robbiesm/MotoZ_Dev/Research/STEP/perforated-pcb-assembly.stp

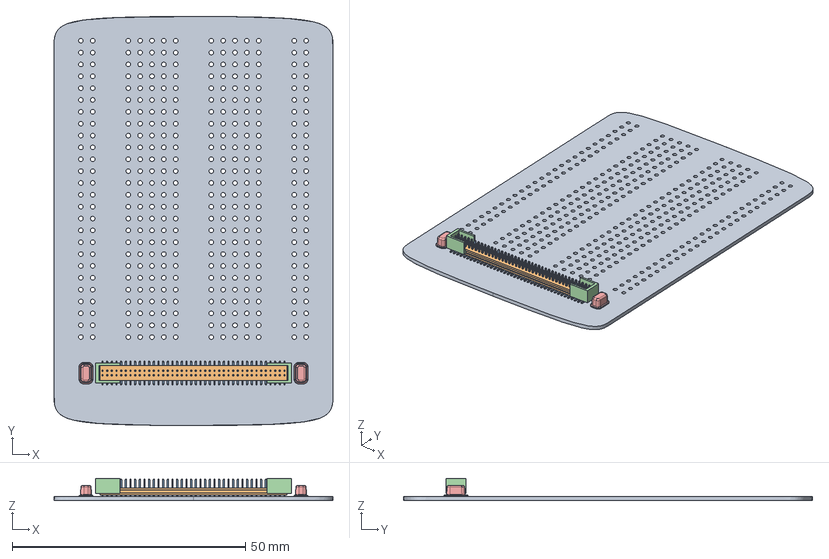
[picture p1: CAD file, 2018-05-24]
Research/STEP/perforated-pcb-assembly.stp
59.7 x 87.6 x 4.78 mm
0_HDK_AMP_SKEL
84016635_HDK_BREADBOARD
_FTMH-140-02-L-DV-ES-P-TR_BODY
_FTMH-140-02-L-DV-ES-P-TR_PINS1
_FTMH-40-ES_SHROUD x 2
PUCK_DETENT_SMT_HDK x 2
