robbiesm/MotoZ_Dev/Research/STEP/personality-card-housing.stp

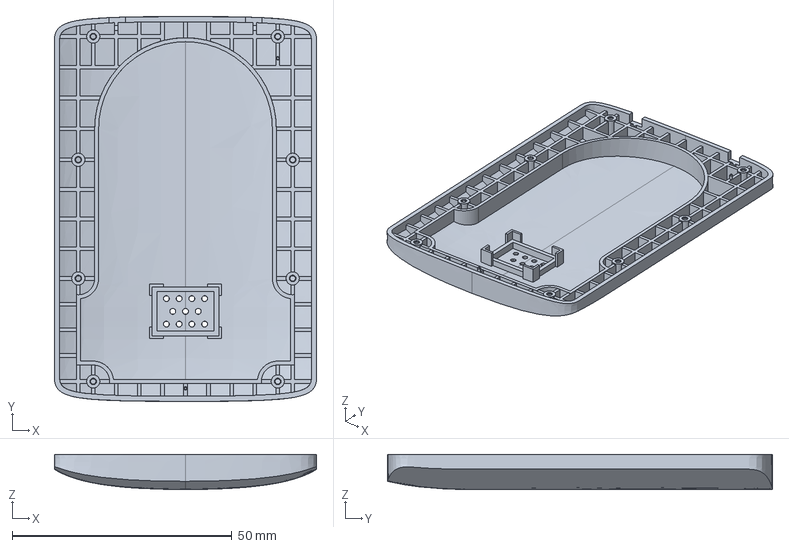
[picture p2: CAD file, 2018-05-24]
Research/STEP/personality-card-housing.stp
59.7 x 87.6 x 7.97 mm
