robbiesm/MotoZ_Dev/Research/STEP/mdk_back_cover.stp

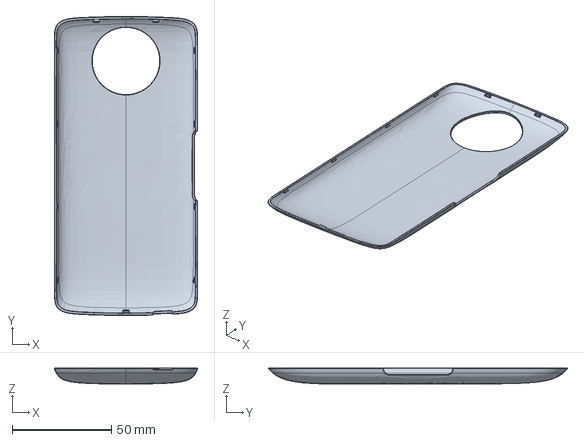
[picture p3: CAD file, 2018-05-24]
Research/STEP/mdk_back_cover.stp
72.2 x 150.4 x 8.04 mm
