robbiesm/MotoZ_Dev/Research/Schematic/DAUGHTER_AUDIO_SCH_0725.pdf

1 | 1
3 | 3

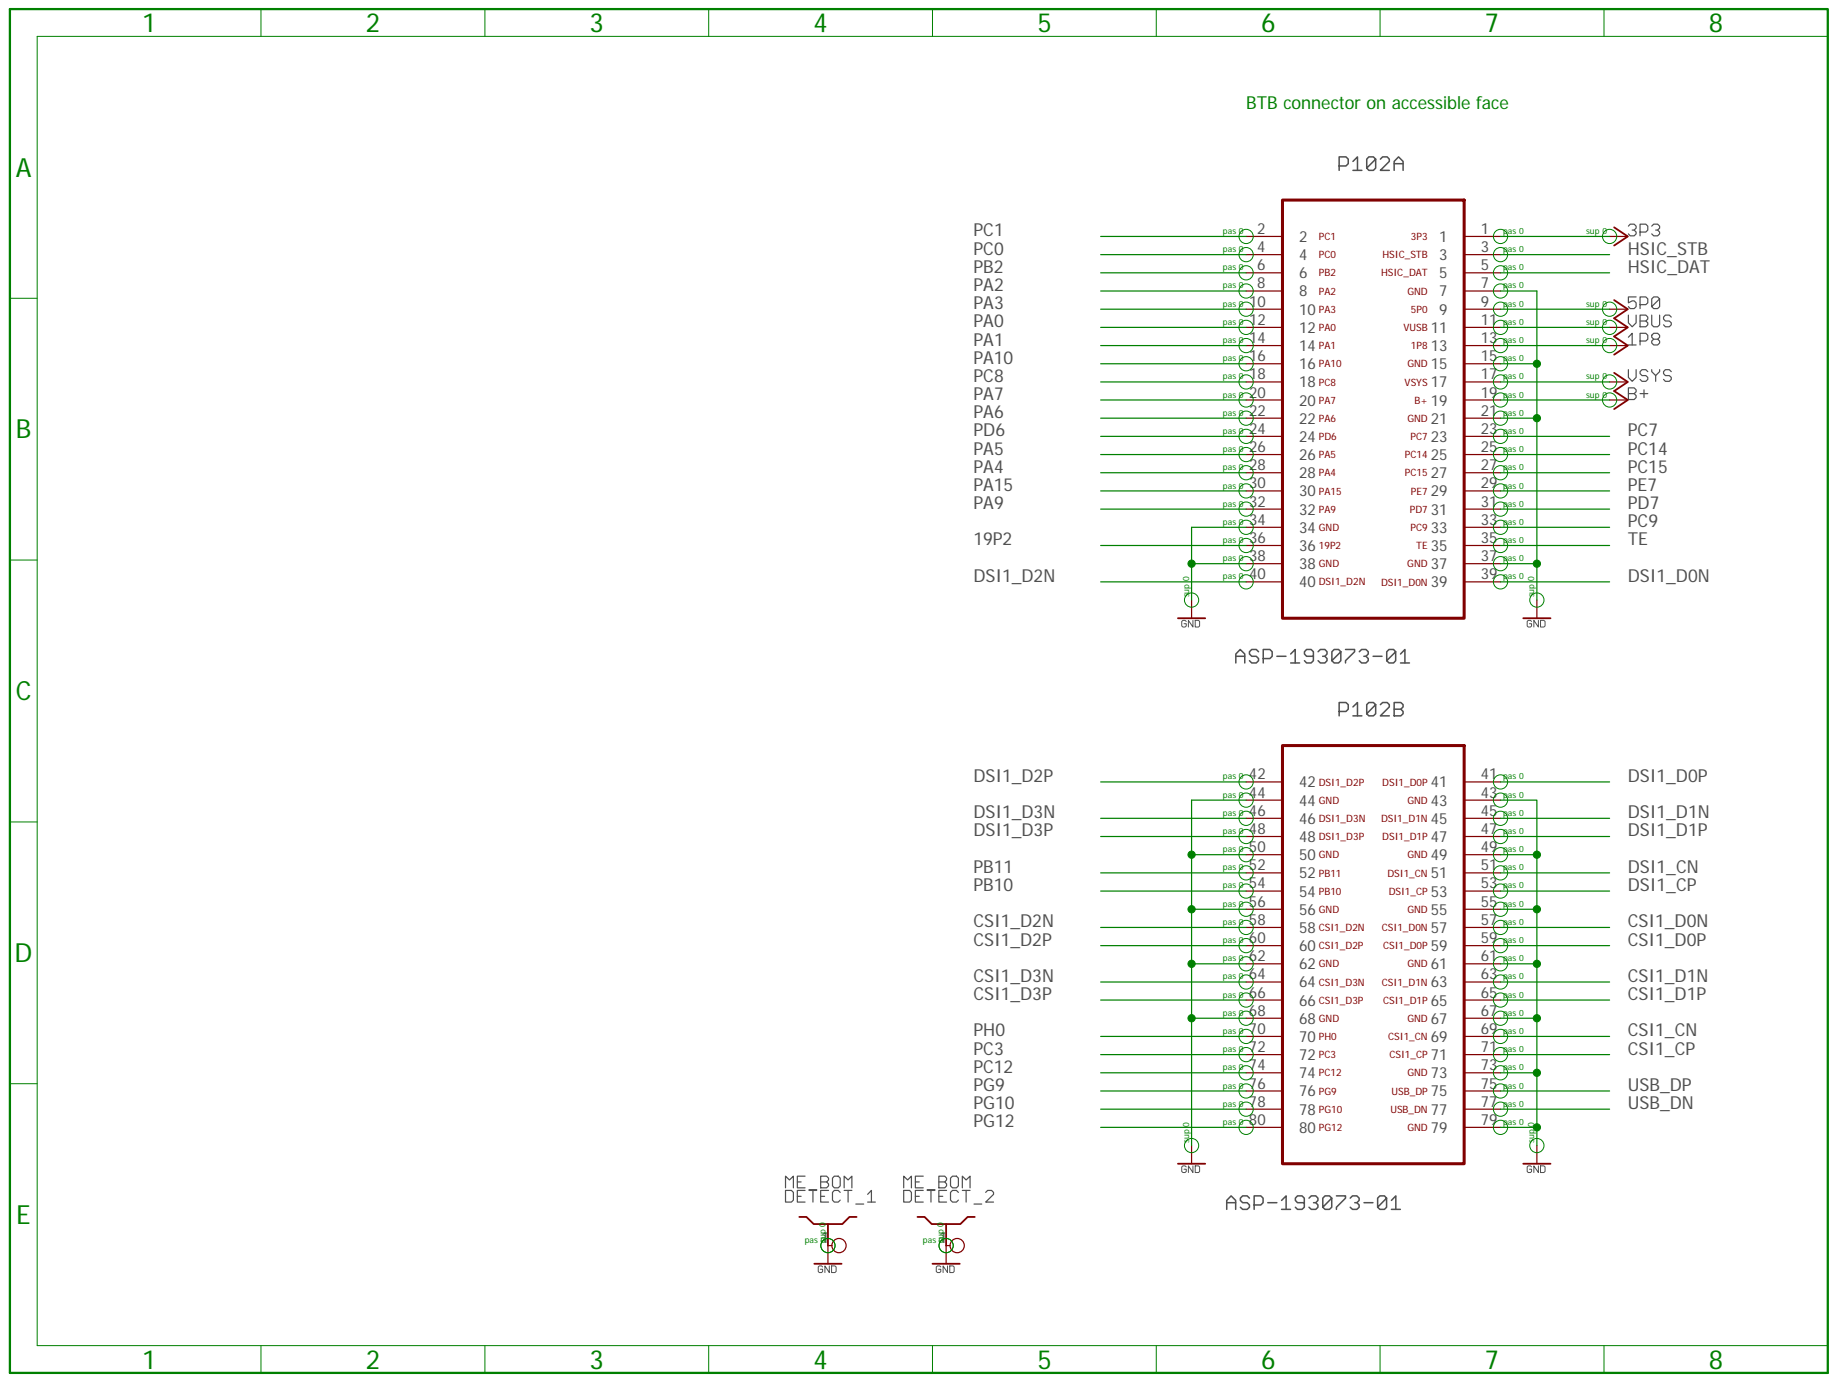
[picture p4: page 1]
HSIC_STB HSIC_DAT; USB_DP USB_DN; DSI1_D2N; DSI1_D0N; DSI1_D2P; DSI1_D3N DSI1_D3P; CSI1_D2N CSI1_D2P; CSI1_D3N CSI1_D3P; CSI1_CP; CSI1_CN; CSI1_D1P; CSI1_D1N; CSI1_D0P; CSI1_D0N; DSI1_CP; DSI1_CN; DSI1_D1P; DSI1_D1N; DSI1_D0P; HSIC_STB; HSIC_DAT GND 5P0 VUSB 1P8 GND VSYS B+ GND PC7 PC14 PC15 PE7 PD7 PC9 TE; GND; DSI1_D0P GND DSI1_D1N DSI1_D1P; DSI1_CN DSI1_CP; CSI1_D0N CSI1_D0P; CSI1_D1N CSI1_D1P; CSI1_CN CSI1_CP; CSI1_D3P; CSI1_D3N; CSI1_D2P; CSI1_D2N; sup 0; pas 0; pas 0sup 0

BTB connector on accessible face

# LED_A

A

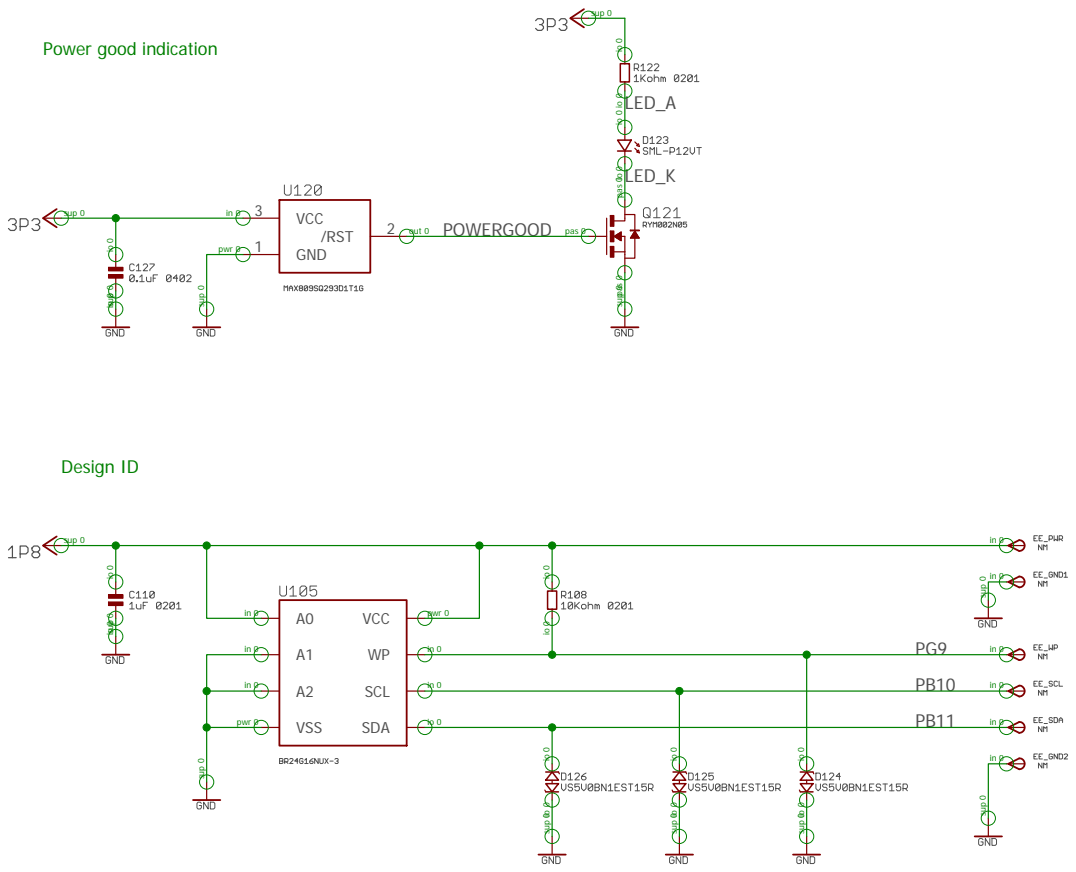
[picture p5: page 2]
VCC 3; GND 1; /RST; VCC; VSS; SDA; SCL; POWERGOOD; LED_K; pwr 0; out 0; sup 0; Design ID

Power good indication

io 0 io 0 pas 0 pas 0 pas 0

io 0 io 0 io 0 io 0 sup 0

U300

PG10

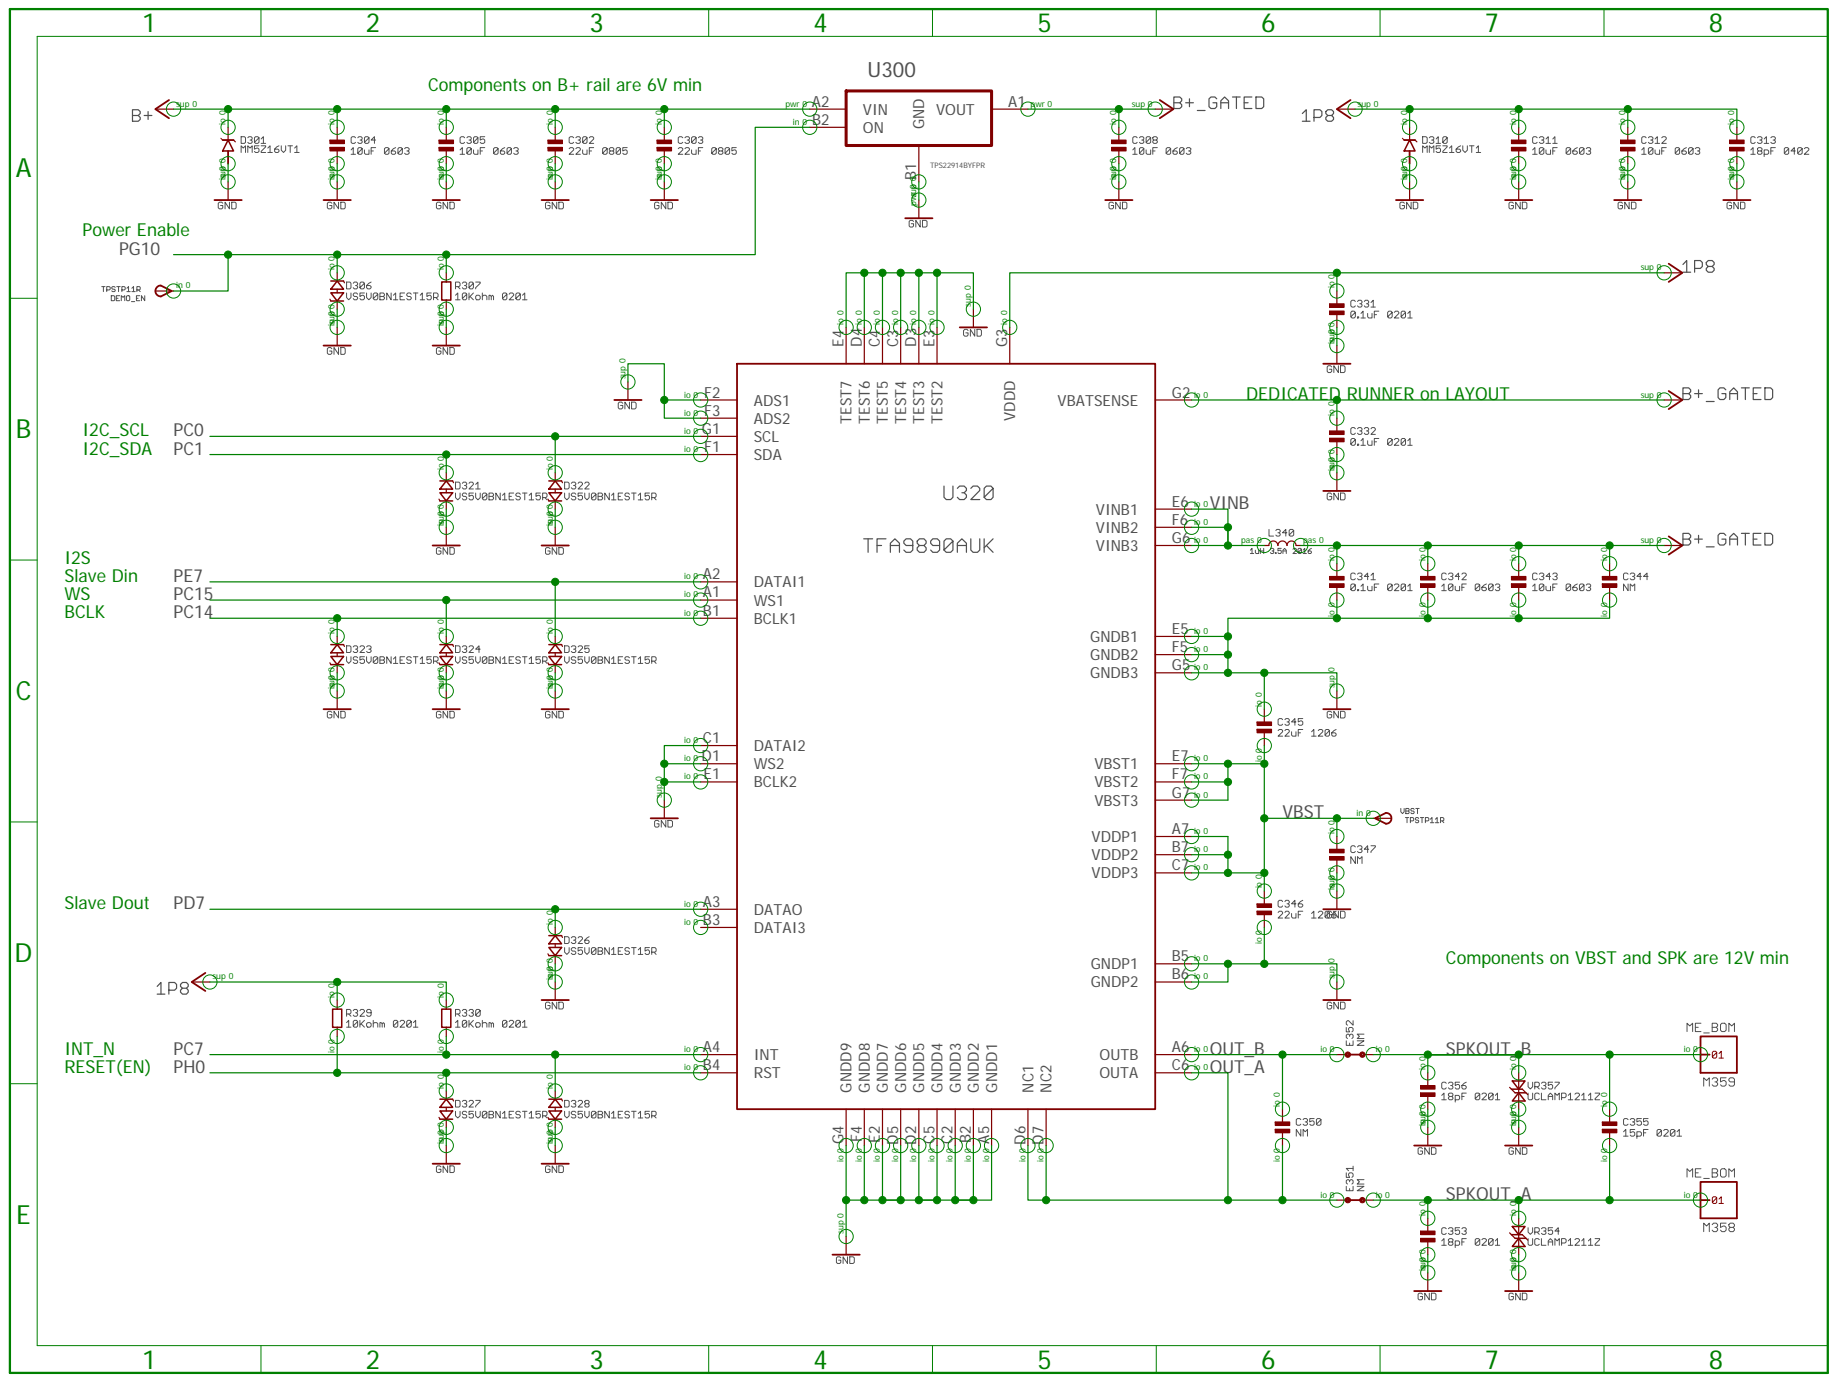
[picture p6: page 3]

Components on B+ rail are 6V min

GND B1 VOUT A1 ON B2 VIN A2
pwr 0

DEDICATED RUNNER on LAYOUT

sup 0 sup 0

Components on VBST and SPK are 12V min
