robbiesm/MotoZ_Dev/Research/Eagle/DAUGHTER_POWER_HW_v1/DAUGHTER_POWER_SCH_0725.pdf

1 | 1
3 | 3

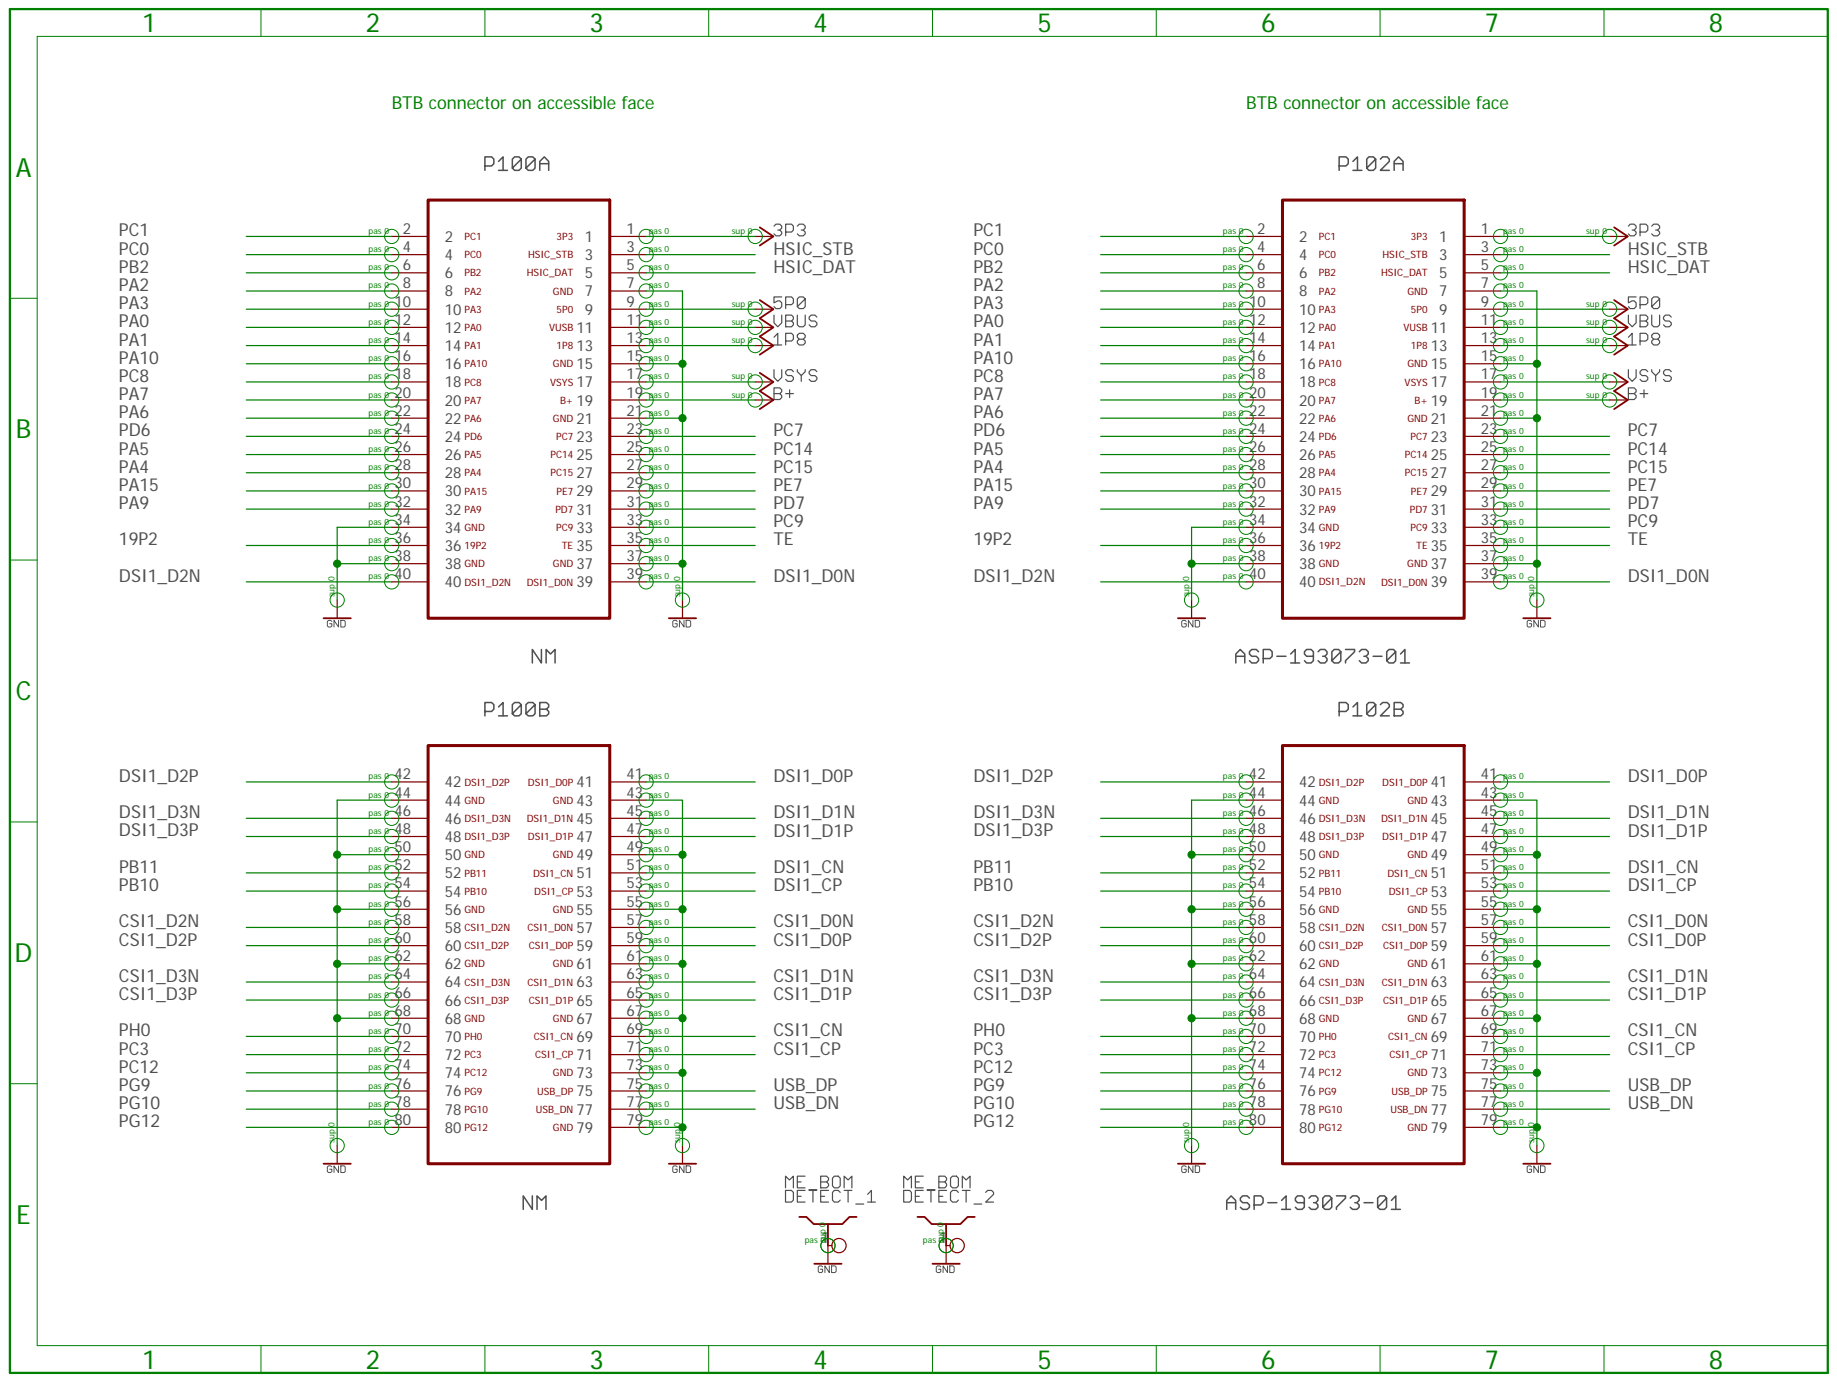
[picture p7: page 1]
HSIC_STB; HSIC_DAT; USB_DP; USB_DN; DSI1_D2N; DSI1_D0N; DSI1_D2P; DSI1_D3N; DSI1_D3P; CSI1_D2N; CSI1_D2P; CSI1_D3N; CSI1_D3P; CSI1_CP; CSI1_CN; CSI1_D1P; CSI1_D1N; CSI1_D0P; CSI1_D0N; DSI1_CP; DSI1_CN; DSI1_D1P; DSI1_D1N; DSI1_D0P; GND; HSIC_DAT GND 5P0 VUSB 1P8 GND VSYS B+ GND PC7 PC14 PC15 PE7; DSI1_D0P GND DSI1_D1N DSI1_D1P; DSI1_CN DSI1_CP; CSI1_D0N CSI1_D0P; CSI1_D1N CSI1_D1P; CSI1_CN CSI1_CP; USB_DP USB_DN; DSI1_D3N DSI1_D3P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

# LED_A

A

VCC 3; GND 1; /RST; VCC; VSS; SDA; SCL; POWERGOOD; LED_K; pwr 0; out 0; sup 0; Design ID

Power good indication

io 0 io 0 pas 0 pas 0 pas 0

io 0 io 0 io 0 io 0 sup 0

# AIN 2 SCL 3 SDA 4

ALRT 8 | THRM 9

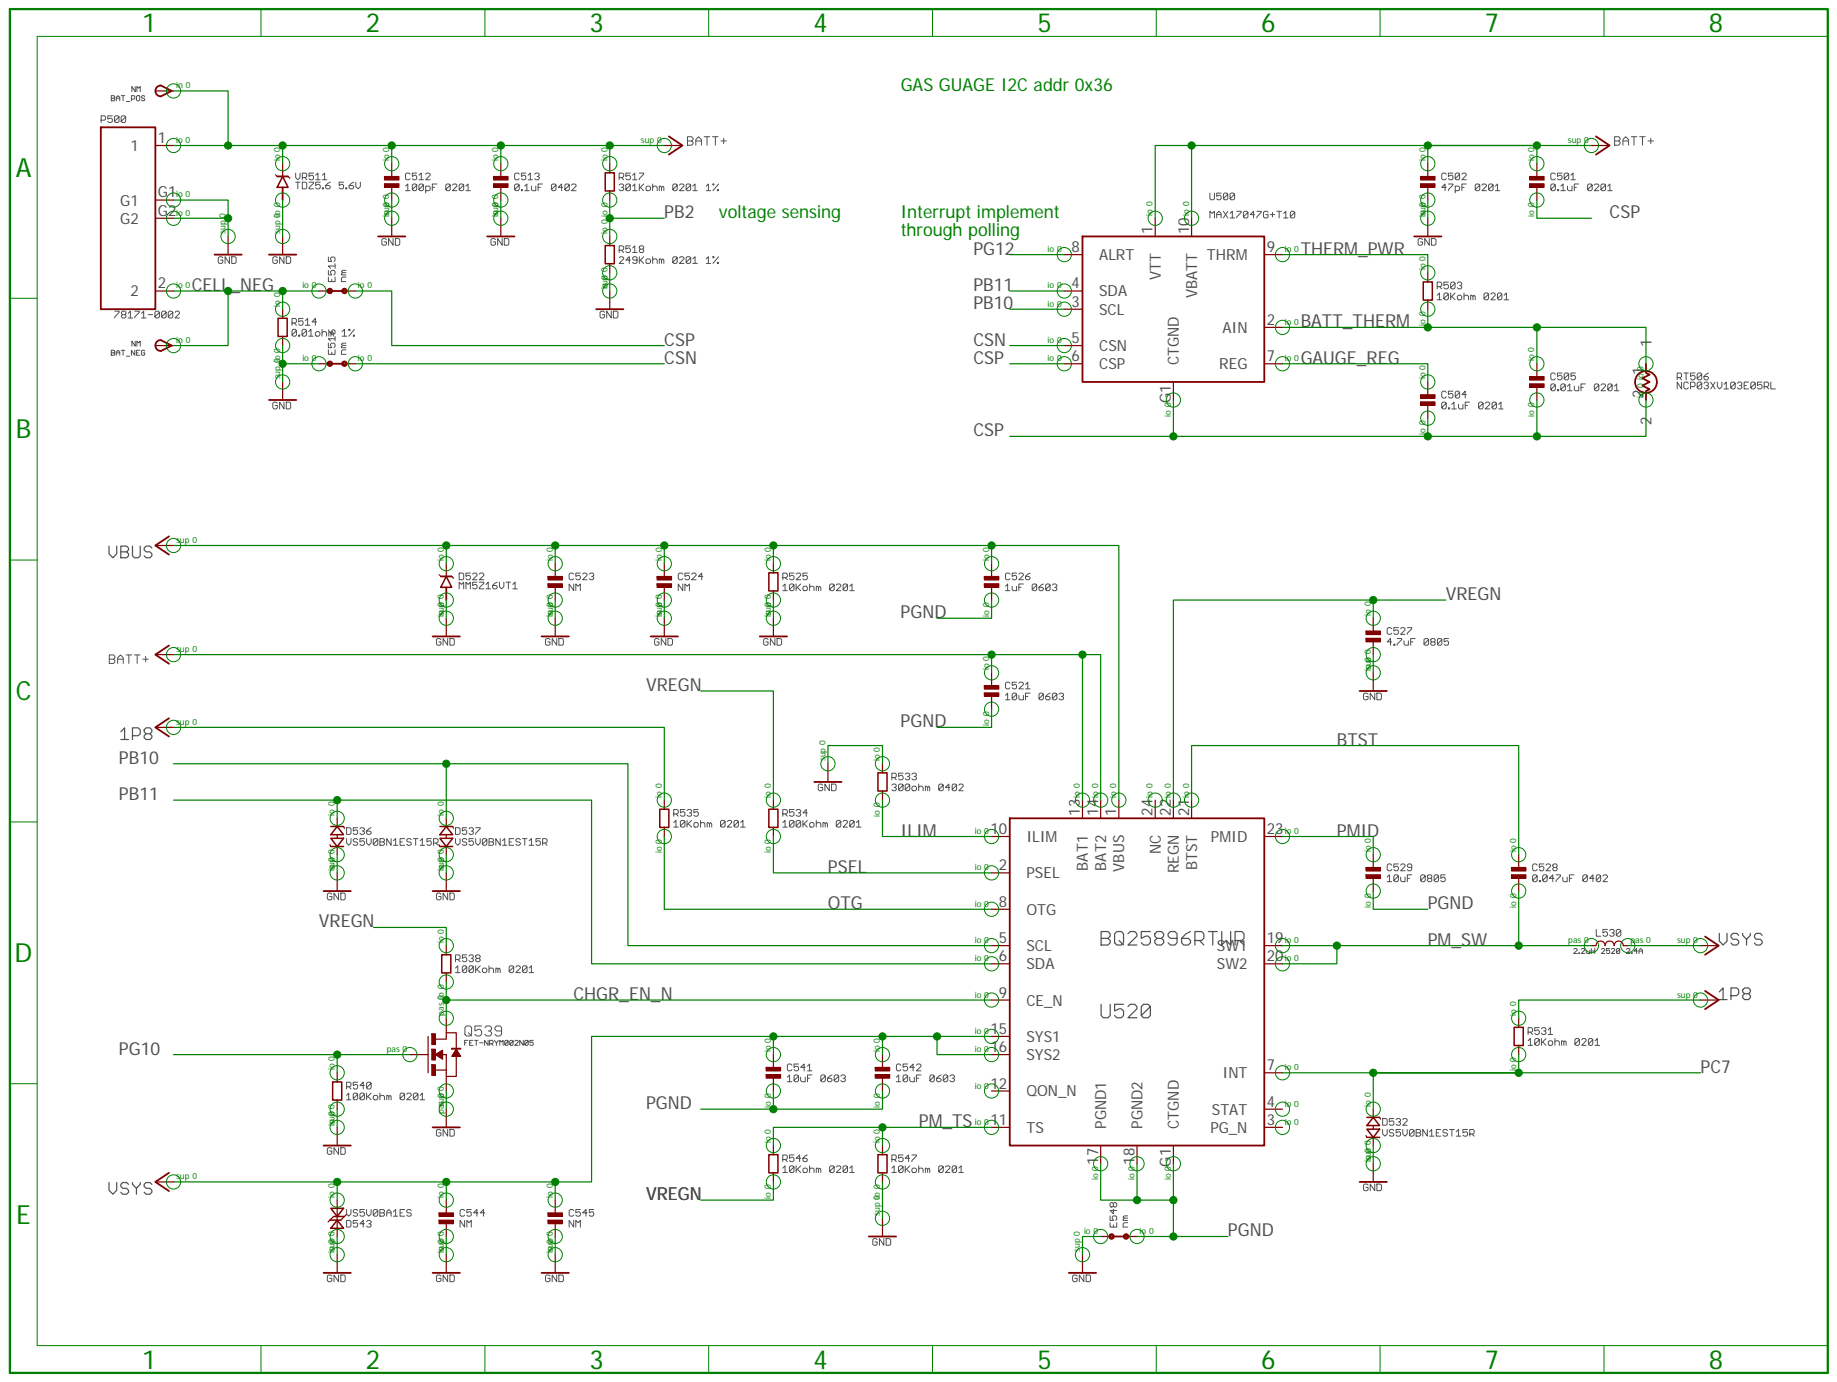
[picture p8: page 3]
VTT; CSN 5; CSP 6; REG 7; VBATT 10 CTGND G1; ILIM 10; PSEL 2; OTG 8; SCL 5 SDA 6; SYS1 15 SYS2 16; QON_N 12; PGND¹ 17; PGND2 18; CTGND G1 PG_N 3 STAT 4; INT 7; PMID 23; VBUS; 1 BAT2 14 BAT1 13; REGN 22; BTST 21; GAUGE_REG; BATT_THERM; THERM_PWR; CSP; CSN; CELL_NEG; OTG; PSEL; ILIM; VREGN; CHGR_EN_N; PGND; BTST; PMID; sup 0; pas 0; sup 0 sup 0; sup 0 sup 0sup 0; voltage sensing; Interrupt implement; through polling

GAS GUAGE I2C addr 0x36

io 0 io 0 sup 0

pas 0 pas 0 pas 0 io 0 io 0
