robbiesm/MotoZ_Dev/Research/Eagle/DAUGHTER_SENSOR_HW_v1/DAUGHTER_SENSOR_SCH_0725.pdf

1 | 1
3 | 3

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

# LED_A

A

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

Power good indication

io 0 io 0 pas 0 pas 0 pas 0

io 0 io 0 io 0 io 0 sup 0

U200

U210

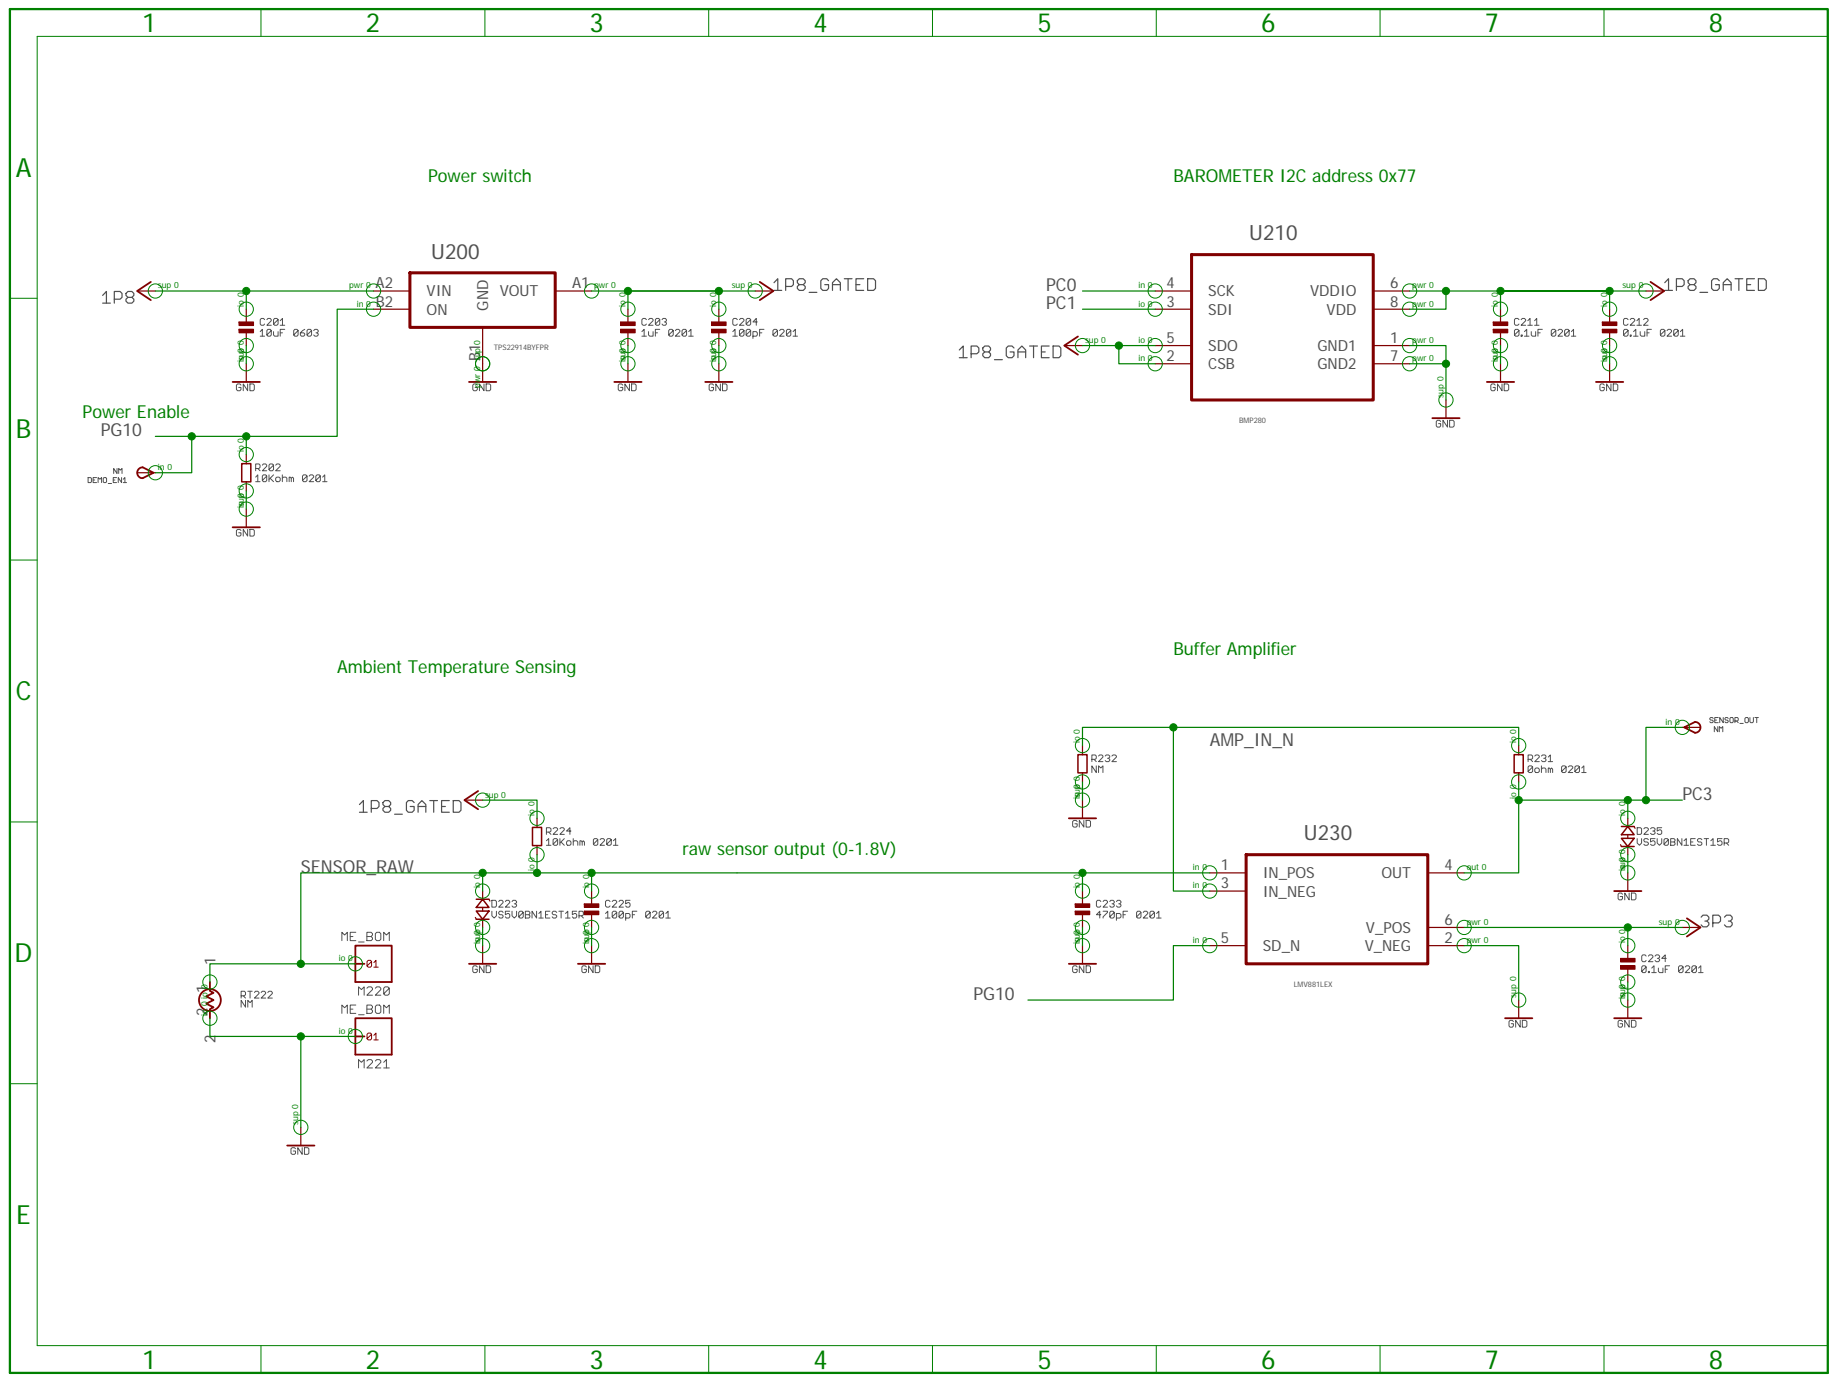
[picture p9: page 3]
TPS22914BYFPR; BMP280; LMV881LEX; VDDIO; VDD; 8 SDI 3; SCK 4; CSB 2; SDO 5; GND2; 7 GND1; V_POS; V_NEG; IN_POS 1 IN_NEG 3; OUT; SENSOR_RAW; AMP_IN_N; pwr 0; sup 0; io 0 sup 0; out 0; Power Enable; Power switch; BAROMETER I2C address 0x77; Buffer Amplifier

GND B1 VOUT A1 ON B2 VIN A2
pwr 0

io 0 io 0 sup 0 sup 0

Ambient Temperature Sensing

io 0 io 0 sup 0

raw sensor output (0-1.8V)
