robbiesm/MotoZ_Dev/Research/Eagle/DAUGHTER_SENSOR_JUMPER_HW_v1/DAUGHTER_SENSOR_JUMPER_SCH.pdf

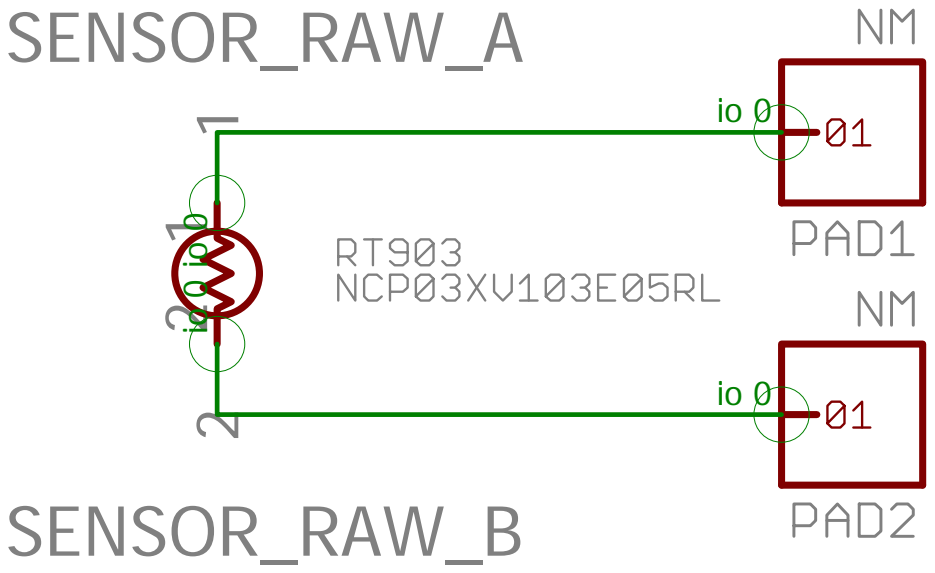
[picture p10: page 1]
SENSOR_RAW_B; SENSOR_RAW_A
