robbiesm/MotoZ_Dev/Research/Eagle/DAUGHTER_SENSOR_JUMPER_HW_v1/DAUGHTER_SENSOR_JUMPER.brd

## EAGLE design Research/Eagle/DAUGHTER_SENSOR_JUMPER_HW_v1/DAUGHTER_SENSOR_JUMPER.brd (2018-05-24)

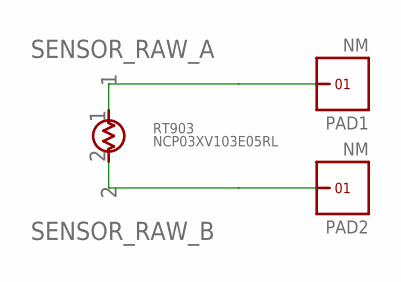
[picture p11: schematic DAUGHTER_SENSOR_JUMPER.sch, SENSOR JUMPER]

Parts:
PAD1, PAD2: NM; PAD_2X3
RT903: NCP03XV103E05RL; 0201

Connections:
SENSOR_RAW_A: PAD1.1, RT903.1
SENSOR_RAW_B: PAD2.1, RT903.2

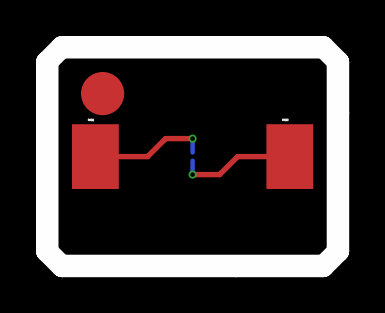
[picture p12: board DAUGHTER_SENSOR_JUMPER.brd from above]

Board: 2 copper layers, 16.2 x 12.2 mm, 3 parts (1 on the bottom side), 2 nets.
