robbiesm/MotoZ_Dev/Research/Eagle/DAUGHTER_AUDIO_HW_v1/DAUGHTER_AUDIO.brd

## EAGLE design Research/Eagle/DAUGHTER_AUDIO_HW_v1/DAUGHTER_AUDIO.brd (2018-05-24)

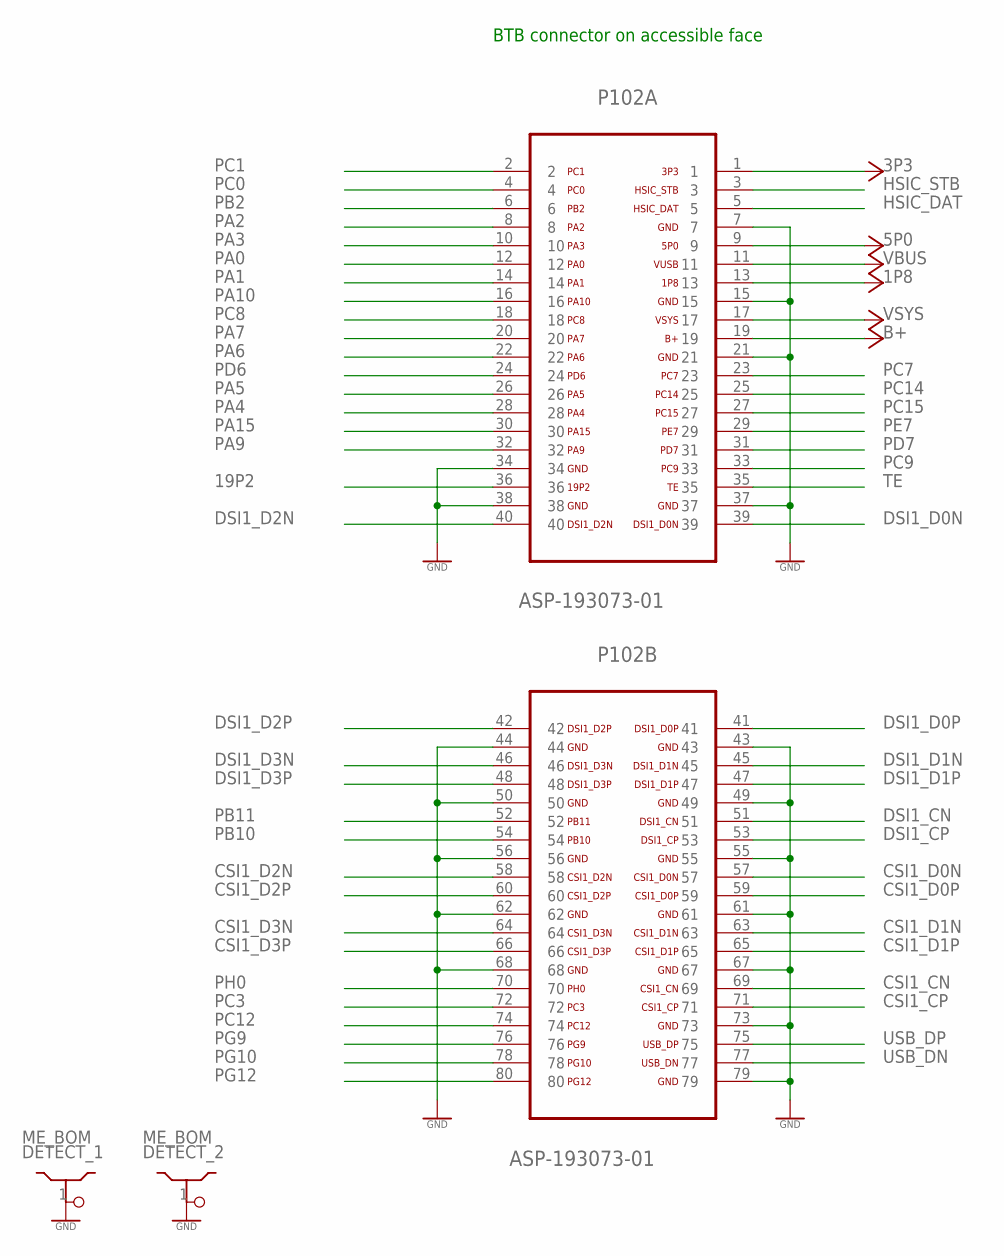
[picture p13: schematic DAUGHTER_AUDIO.sch, sheet 1, HDK INTERFACE]

Parts:
DETECT_1, DETECT_2: ME_BOM; PLUG
P102: ASP-193073-01; FTMH-140-02-L-DV-ES-P-TR; MPN ASP-193073-01

Connections:
1P8: P102.13; also elsewhere on the board
3P3: P102.1; also elsewhere on the board
5P0: P102.9
19P2: P102.36
B+: P102.19; also elsewhere on the board
CSI1_CN: P102.69
CSI1_CP: P102.71
CSI1_D0N: P102.57
CSI1_D0P: P102.59
CSI1_D1N: P102.63
CSI1_D1P: P102.65
CSI1_D2N: P102.58
CSI1_D2P: P102.60
CSI1_D3N: P102.64
CSI1_D3P: P102.66
DSI1_CN: P102.51
DSI1_CP: P102.53
DSI1_D0N: P102.39
DSI1_D0P: P102.41
DSI1_D1N: P102.45
DSI1_D1P: P102.47
DSI1_D2N: P102.40
DSI1_D2P: P102.42
DSI1_D3N: P102.46
DSI1_D3P: P102.48
GND: DETECT_1.1, DETECT_2.1, P102.7, P102.15, P102.21, P102.34, P102.37, P102.38, P102.43, P102.44, P102.49, P102.50, P102.55, P102.56, P102.61, P102.62, P102.67, P102.68, P102.73, P102.79; also elsewhere on the board
HSIC_DAT: P102.5
HSIC_STB: P102.3
PA0: P102.12
PA1: P102.14
PA2: P102.8
PA3: P102.10
PA4: P102.28
PA5: P102.26
PA6: P102.22
PA7: P102.20
PA9: P102.32
PA10: P102.16
PA15: P102.30
PB2: P102.6
PB10: P102.54; also elsewhere on the board
PB11: P102.52; also elsewhere on the board
PC0: P102.4; also elsewhere on the board
PC1: P102.2; also elsewhere on the board
PC3: P102.72
PC7: P102.23; also elsewhere on the board
PC8: P102.18
PC9: P102.33
PC12: P102.74
PC14: P102.25; also elsewhere on the board
PC15: P102.27; also elsewhere on the board
PD6: P102.24
PD7: P102.31; also elsewhere on the board
PE7: P102.29; also elsewhere on the board
PG9: P102.76; also elsewhere on the board
PG10: P102.78; also elsewhere on the board
PG12: P102.80
PH0: P102.70; also elsewhere on the board
TE: P102.35
USB_DN: P102.77
USB_DP: P102.75
VBUS: P102.11
VSYS: P102.17

Notes on the sheet:
BTB connector on accessible face

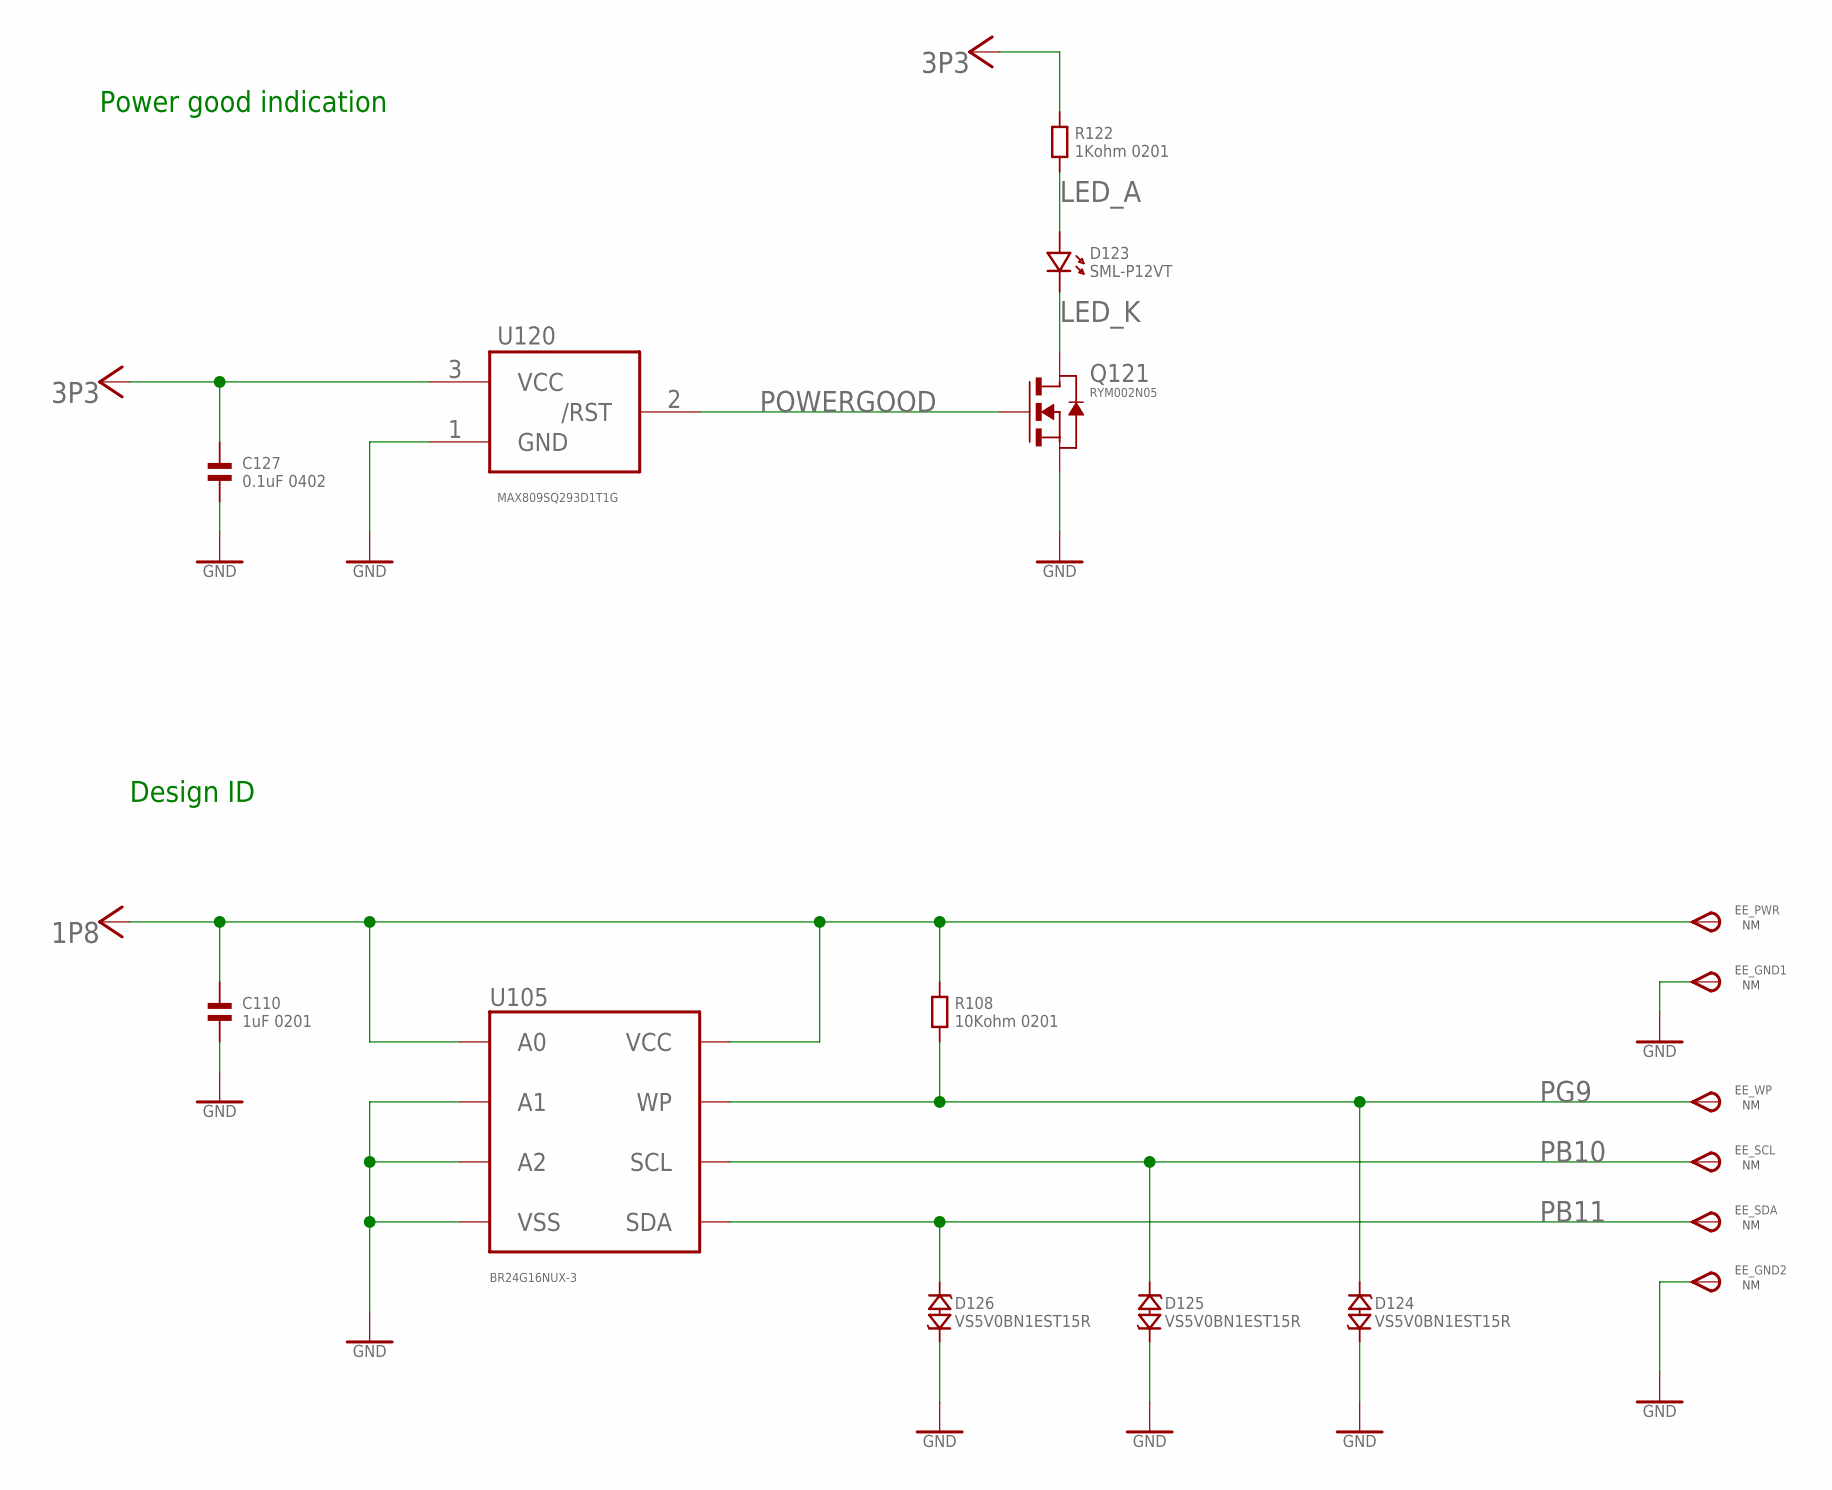
[picture p14: schematic DAUGHTER_AUDIO.sch, sheet 2, Identification]

Parts:
C110: 1uF 0201; 0201
C127: 0.1uF 0402; 0402
D123: SML-P12VT; 0503.LED
D124, D125, D126: VS5V0BN1EST15R; CHIP_0201
EE_GND1, EE_GND2: NM; TP11R
EE_PWR: NM; TP11R
EE_SCL: NM; TP11R
EE_SDA: NM; TP11R
EE_WP: NM; TP11R
Q121: RYM002N05; VMT3
R108: 10Kohm 0201; 0201
R122: 1Kohm 0201; 0201
U105: BR24G16NUX-3; DFN-8
U120: MAX809SQ293D1T1G; SC70-3L

Connections:
1P8: C110.1, EE_PWR.TP, R108.1, U105.P$1 (A0), U105.P$8 (VCC); also elsewhere on the board
3P3: C127.1, R122.1, U120.3 (VCC); also elsewhere on the board
GND: C110.2, C127.2, D124.P$2 (2), D125.P$2 (2), D126.P$2 (2), EE_GND1.TP, EE_GND2.TP, Q121.2 (S), U105.P$2 (A1), U105.P$3 (A2), U105.P$4 (VSS), U105.P$9 (VSS), U120.1 (GND); also elsewhere on the board
LED_A: D123.P$1 (1), R122.2
LED_K: D123.P$2 (2), Q121.3 (D)
PB10: D125.P$1 (1), EE_SCL.TP, U105.P$6 (SCL); also elsewhere on the board
PB11: D126.P$1 (1), EE_SDA.TP, U105.P$5 (SDA); also elsewhere on the board
PG9: D124.P$1 (1), EE_WP.TP, R108.2, U105.P$7 (WP); also elsewhere on the board
POWERGOOD: Q121.1 (G), U120.2 (/RST)

Notes on the sheet:
Power good indication
Design ID

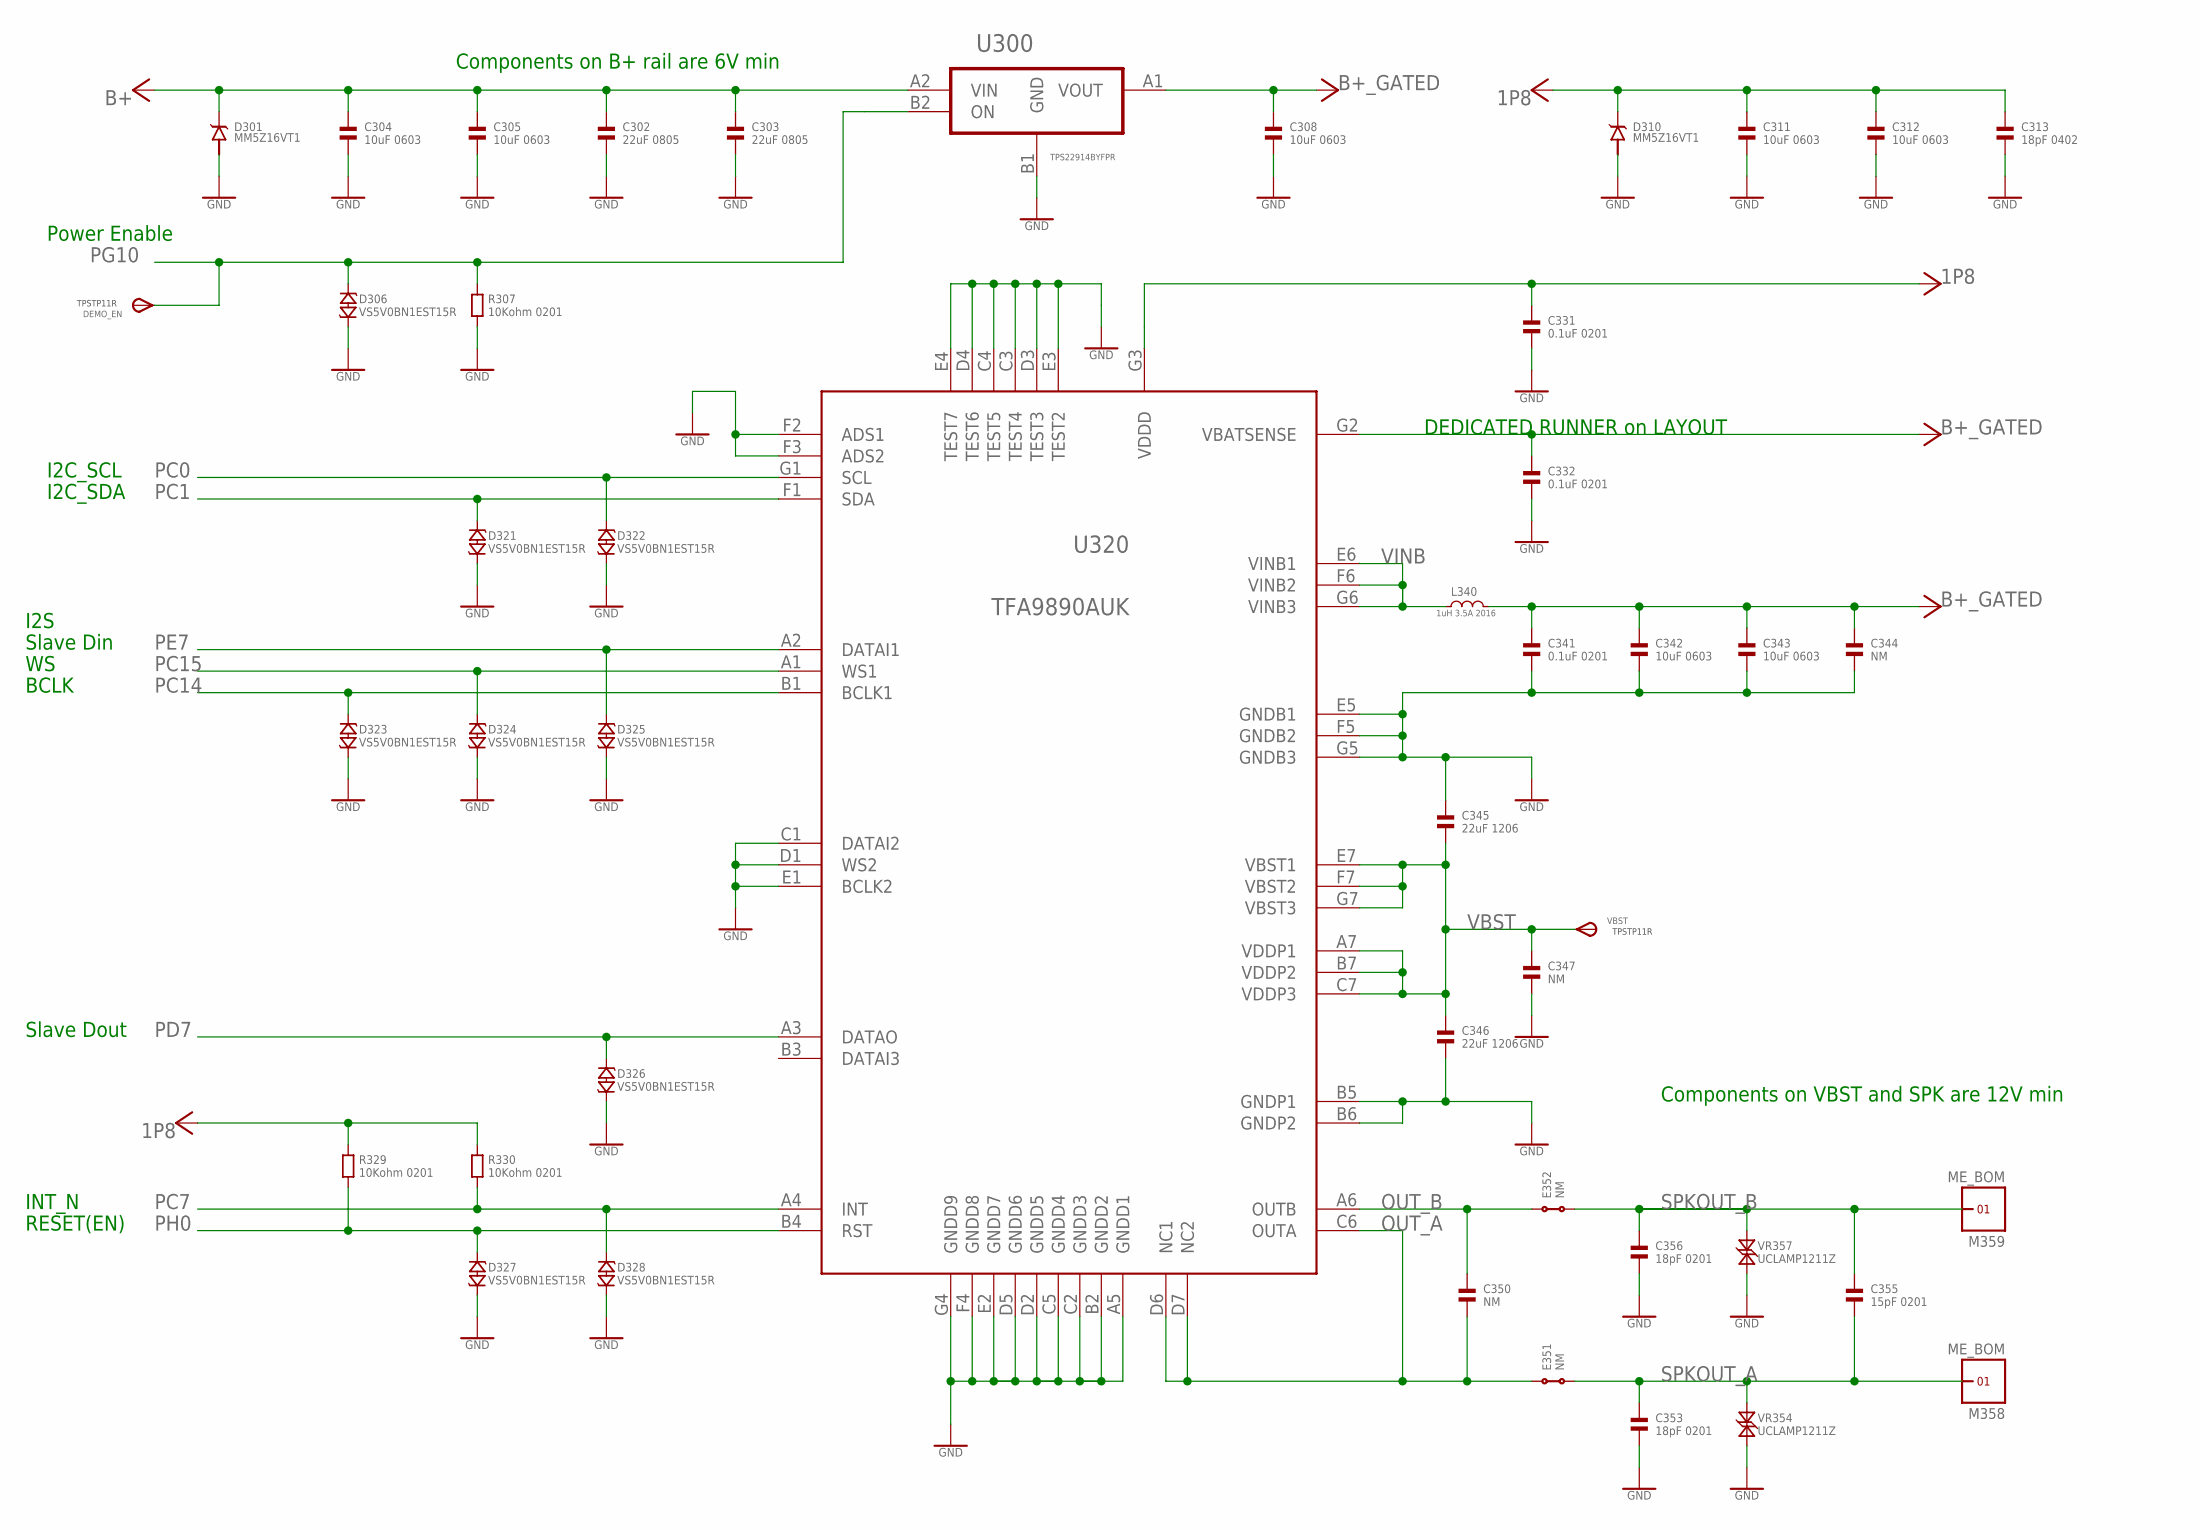
[picture p15: schematic DAUGHTER_AUDIO.sch, sheet 3, LOUD SPEAKER]

Parts:
C302, C303: 22uF 0805; 0805
C304, C305, C308, C311, C312, C342, C343: 10uF 0603; 0603
C313: 18pF 0402; 0402
C331, C332, C341: 0.1uF 0201; 0201
C344, C347: NM; 0402
C345, C346: 22uF 1206; 1206
C350: NM; 0201
C353, C356: 18pF 0201; 0201
C355: 15pF 0201; 0201
D301, D310: MM5Z16VT1; SOD523
D306, D321, D322, D323, D324, D325, D326, D327, D328: VS5V0BN1EST15R; CHIP_0201
DEMO_EN: TPSTP11R; TP11R
E351, E352: NM; 0603_SHORT
L340: 1uH 3.5A 2016; 2016
M358, M359: ME_BOM; PUCK
R307, R329, R330: 10Kohm 0201; 0201
U300: TPS22914BYFPR; BGA0_75SQ_PS0_4_P4
U320: TFA9890AUK; BGA7X7
VBST: TPSTP11R; TP11R
VR354, VR357: UCLAMP1211Z; CHIP_0201

Connections:
1P8: C311.1, C312.1, C313.1, C331.1, D310.1, R329.1, R330.1, U320.G3 (VDDD); also elsewhere on the board
B+: C302.1, C303.1, C304.1, C305.1, D301.1, U300.A2 (VIN); also elsewhere on the board
B+_GATED: C308.1, C332.1, C341.1, C342.1, C343.1, C344.1, L340.2, U300.A1 (VOUT), U320.G2 (VBATSENSE)
GND: C302.2, C303.2, C304.2, C305.2, C308.2, C311.2, C312.2, C313.2, C331.2, C332.2, C341.2, C342.2, C343.2, C344.2, C345.1, C346.2, C347.2, C353.2, C356.2, D301.2, D306.P$2 (2), D310.2, D321.P$2 (2), D322.P$2 (2), D323.P$2 (2), D324.P$2 (2), D325.P$2 (2), D326.P$2 (2), D327.P$2 (2), D328.P$2 (2), R307.2, U300.B1 (GND), U320.A5 (GNDD1), U320.B2 (GNDD2), U320.B5 (GNDP1), U320.B6 (GNDP2), U320.C1 (DATAI2), U320.C2 (GNDD3), U320.C3 (TEST4), U320.C4 (TEST5), U320.C5 (GNDD4), U320.D1 (WS2), U320.D2 (GNDD5), U320.D3 (TEST3), U320.D4 (TEST6), U320.D5 (GNDD6), U320.E1 (BCLK2), U320.E2 (GNDD7), U320.E3 (TEST2), U320.E4 (TEST7), U320.E5 (GNDB1), U320.F2 (ADS1), U320.F3 (ADS2), U320.F4 (GNDD8), U320.F5 (GNDB2), U320.G4 (GNDD9), U320.G5 (GNDB3), VR354.P$2 (2), VR357.P$2 (2); also elsewhere on the board
OUT_A: C350.2, E351.1, U320.C6 (OUTA), U320.D6 (NC1), U320.D7 (NC2)
OUT_B: C350.1, E352.1, U320.A6 (OUTB)
PC0: D322.P$1 (1), U320.G1 (SCL); also elsewhere on the board
PC1: D321.P$1 (1), U320.F1 (SDA); also elsewhere on the board
PC7: D328.P$1 (1), R330.2, U320.A4 (INT); also elsewhere on the board
PC14: D323.P$1 (1), U320.B1 (BCLK1); also elsewhere on the board
PC15: D324.P$1 (1), U320.A1 (WS1); also elsewhere on the board
PD7: D326.P$1 (1), U320.A3 (DATAO); also elsewhere on the board
PE7: D325.P$1 (1), U320.A2 (DATAI1); also elsewhere on the board
PG10: D306.P$1 (1), DEMO_EN.TP, R307.1, U300.B2 (ON); also elsewhere on the board
PH0: D327.P$1 (1), R329.2, U320.B4 (RST); also elsewhere on the board
SPKOUT_A: C353.1, C355.2, E351.2, M358.1, VR354.P$1 (1)
SPKOUT_B: C355.1, C356.1, E352.2, M359.1, VR357.P$1 (1)
VBST: C345.2, C346.1, C347.1, U320.A7 (VDDP1), U320.B7 (VDDP2), U320.C7 (VDDP3), U320.E7 (VBST1), U320.F7 (VBST2), U320.G7 (VBST3), VBST.TP
VINB: L340.1, U320.E6 (VINB1), U320.F6 (VINB2), U320.G6 (VINB3)

Notes on the sheet:
Power Enable
I2C_SCL
I2C_SDA
BCLK
I2S
Slave Dout
Slave Din
INT_N
RESET(EN)
DEDICATED RUNNER on LAYOUT
Components on VBST and SPK are 12V min
Components on B+ rail are 6V min

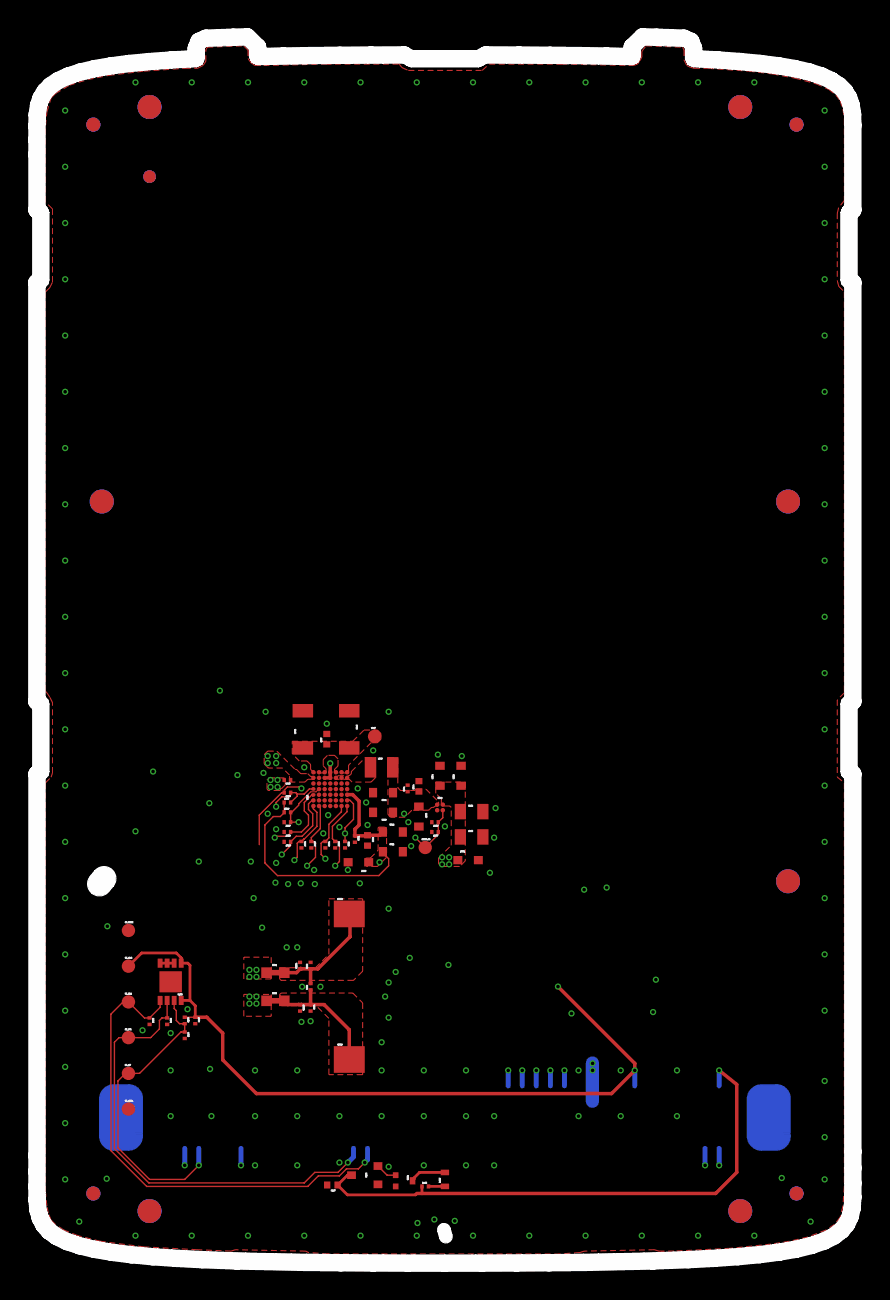
[picture p16: board DAUGHTER_AUDIO.brd from above]

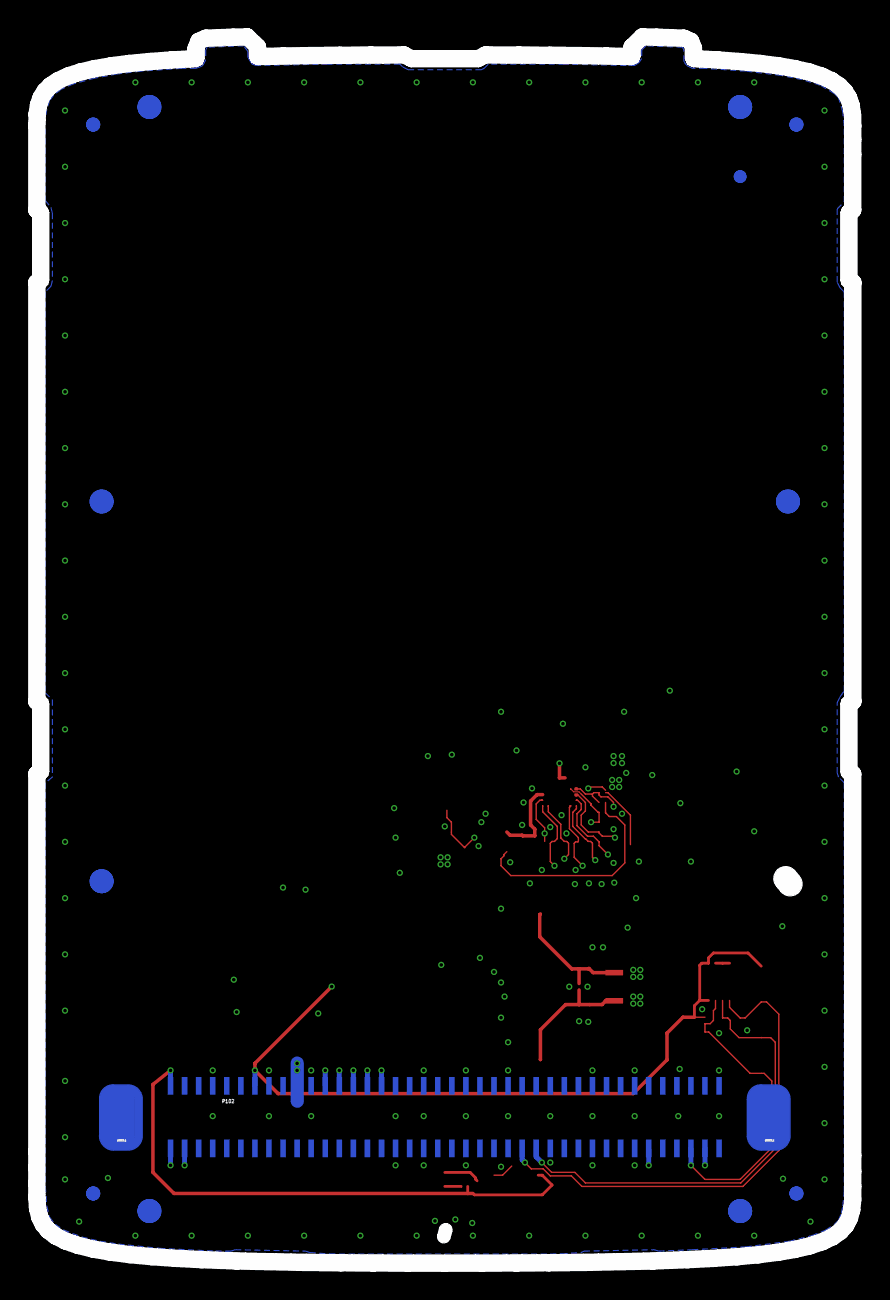
[picture p17: board DAUGHTER_AUDIO.brd from below]

Board: 4 copper layers, 58.1 x 87.2 mm, 66 parts (3 on the bottom side), 26 nets.
