robbiesm/MotoZ_Dev/Research/Eagle/DAUGHTER_SENSOR_HW_v1/DAUGHTER_SENSOR.brd

## EAGLE design Research/Eagle/DAUGHTER_SENSOR_HW_v1/DAUGHTER_SENSOR.brd (2018-05-24)

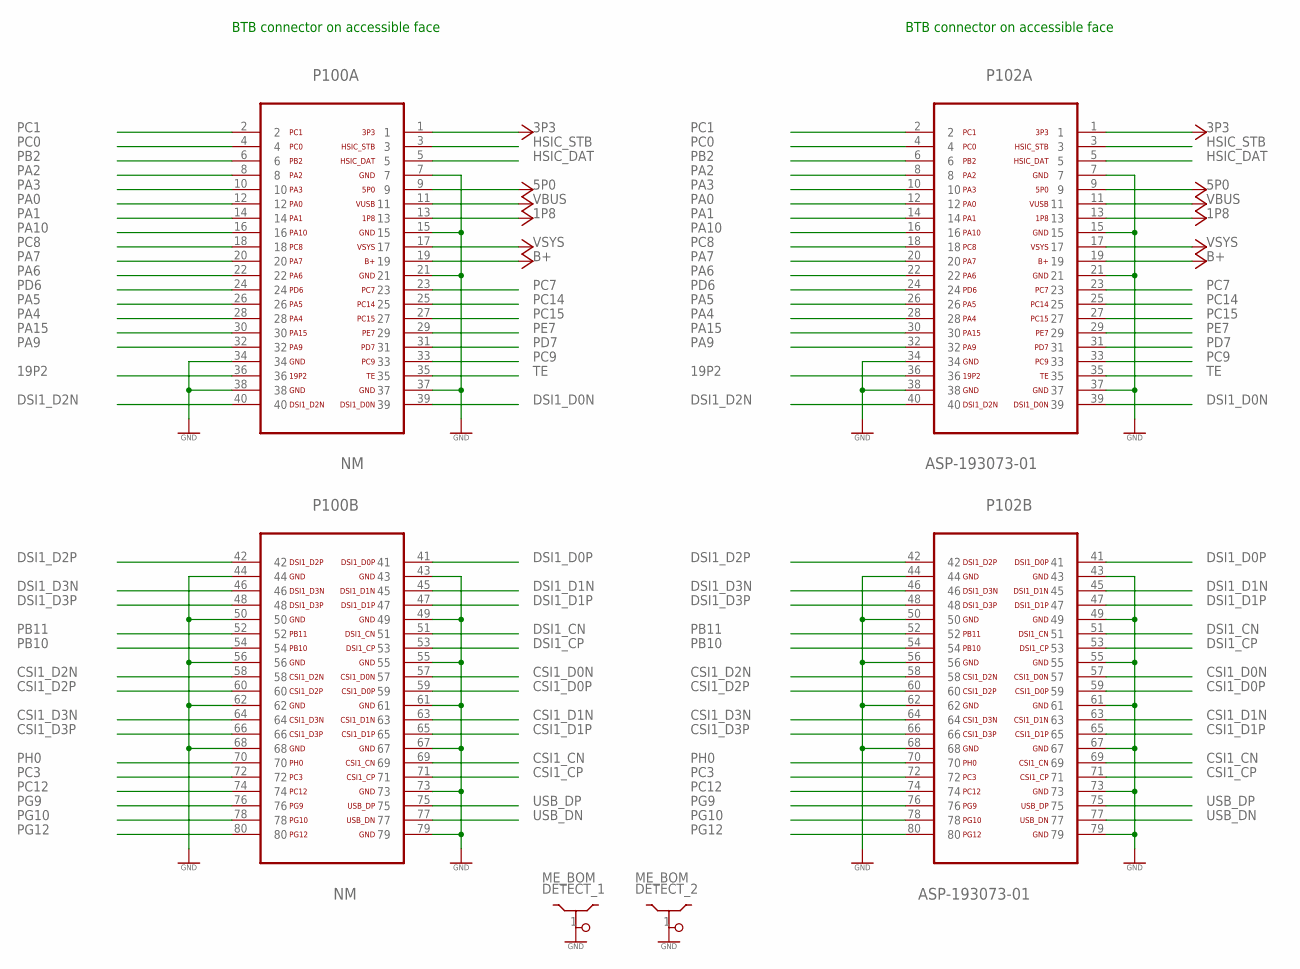
[picture p18: schematic DAUGHTER_SENSOR.sch, sheet 1, HDK INTERFACE]

Parts:
DETECT_1, DETECT_2: ME_BOM; PLUG
P100: NM; CLM-140-02-L-D-K_GOLD
P102: ASP-193073-01; FTMH-140-02-L-DV-ES-P-TR; MPN ASP-193073-01

Connections:
1P8: P100.13, P102.13; also elsewhere on the board
3P3: P100.1, P102.1; also elsewhere on the board
5P0: P100.9, P102.9
19P2: P100.36, P102.36
B+: P100.19, P102.19
CSI1_CN: P100.69, P102.69
CSI1_CP: P100.71, P102.71
CSI1_D0N: P100.57, P102.57
CSI1_D0P: P100.59, P102.59
CSI1_D1N: P100.63, P102.63
CSI1_D1P: P100.65, P102.65
CSI1_D2N: P100.58, P102.58
CSI1_D2P: P100.60, P102.60
CSI1_D3N: P100.64, P102.64
CSI1_D3P: P100.66, P102.66
DSI1_CN: P100.51, P102.51
DSI1_CP: P100.53, P102.53
DSI1_D0N: P100.39, P102.39
DSI1_D0P: P100.41, P102.41
DSI1_D1N: P100.45, P102.45
DSI1_D1P: P100.47, P102.47
DSI1_D2N: P100.40, P102.40
DSI1_D2P: P100.42, P102.42
DSI1_D3N: P100.46, P102.46
DSI1_D3P: P100.48, P102.48
GND: DETECT_1.1, DETECT_2.1, P100.7, P100.15, P100.21, P100.34, P100.37, P100.38, P100.43, P100.44, P100.49, P100.50, P100.55, P100.56, P100.61, P100.62, P100.67, P100.68, P100.73, P100.79, P102.7, P102.15, P102.21, P102.34, P102.37, P102.38, P102.43, P102.44, P102.49, P102.50, P102.55, P102.56, P102.61, P102.62, P102.67, P102.68, P102.73, P102.79; also elsewhere on the board
HSIC_DAT: P100.5, P102.5
HSIC_STB: P100.3, P102.3
PA0: P100.12, P102.12
PA1: P100.14, P102.14
PA2: P100.8, P102.8
PA3: P100.10, P102.10
PA4: P100.28, P102.28
PA5: P100.26, P102.26
PA6: P100.22, P102.22
PA7: P100.20, P102.20
PA9: P100.32, P102.32
PA10: P100.16, P102.16
PA15: P100.30, P102.30
PB2: P100.6, P102.6
PB10: P100.54, P102.54; also elsewhere on the board
PB11: P100.52, P102.52; also elsewhere on the board
PC0: P100.4, P102.4; also elsewhere on the board
PC1: P100.2, P102.2; also elsewhere on the board
PC3: P100.72, P102.72; also elsewhere on the board
PC7: P100.23, P102.23
PC8: P100.18, P102.18
PC9: P100.33, P102.33
PC12: P100.74, P102.74
PC14: P100.25, P102.25
PC15: P100.27, P102.27
PD6: P100.24, P102.24
PD7: P100.31, P102.31
PE7: P100.29, P102.29
PG9: P100.76, P102.76; also elsewhere on the board
PG10: P100.78, P102.78; also elsewhere on the board
PG12: P100.80, P102.80
PH0: P100.70, P102.70
TE: P100.35, P102.35
USB_DN: P100.77, P102.77
USB_DP: P100.75, P102.75
VBUS: P100.11, P102.11
VSYS: P100.17, P102.17

Notes on the sheet:
BTB connector on accessible face


Parts:
C110: 1uF 0201; 0201
C127: 0.1uF 0402; 0402
D123: SML-P12VT; 0503.LED
D124, D125, D126: VS5V0BN1EST15R; CHIP_0201
EE_GND1, EE_GND2: NM; TP11R
EE_PWR: NM; TP11R
EE_SCL: NM; TP11R
EE_SDA: NM; TP11R
EE_WP: NM; TP11R
Q121: RYM002N05; VMT3
R108: 10Kohm 0201; 0201
R122: 1Kohm 0201; 0201
U105: BR24G16NUX-3; DFN-8
U120: MAX809SQ293D1T1G; SC70-3L

Connections:
1P8: C110.1, EE_PWR.TP, R108.1, U105.P$1 (A0), U105.P$8 (VCC); also elsewhere on the board
3P3: C127.1, R122.1, U120.3 (VCC); also elsewhere on the board
GND: C110.2, C127.2, D124.P$2 (2), D125.P$2 (2), D126.P$2 (2), EE_GND1.TP, EE_GND2.TP, Q121.2 (S), U105.P$2 (A1), U105.P$3 (A2), U105.P$4 (VSS), U105.P$9 (VSS), U120.1 (GND); also elsewhere on the board
LED_A: D123.P$1 (1), R122.2
LED_K: D123.P$2 (2), Q121.3 (D)
PB10: D125.P$1 (1), EE_SCL.TP, U105.P$6 (SCL); also elsewhere on the board
PB11: D126.P$1 (1), EE_SDA.TP, U105.P$5 (SDA); also elsewhere on the board
PG9: D124.P$1 (1), EE_WP.TP, R108.2, U105.P$7 (WP); also elsewhere on the board
POWERGOOD: Q121.1 (G), U120.2 (/RST)

Notes on the sheet:
Power good indication
Design ID
