robbiesm/MotoZ_Dev/Research/Eagle/DAUGHTER_SENSOR_HW_v1/DAUGHTER_SENSOR.brd

## EAGLE design Research/Eagle/DAUGHTER_SENSOR_HW_v1/DAUGHTER_SENSOR.brd (continued)

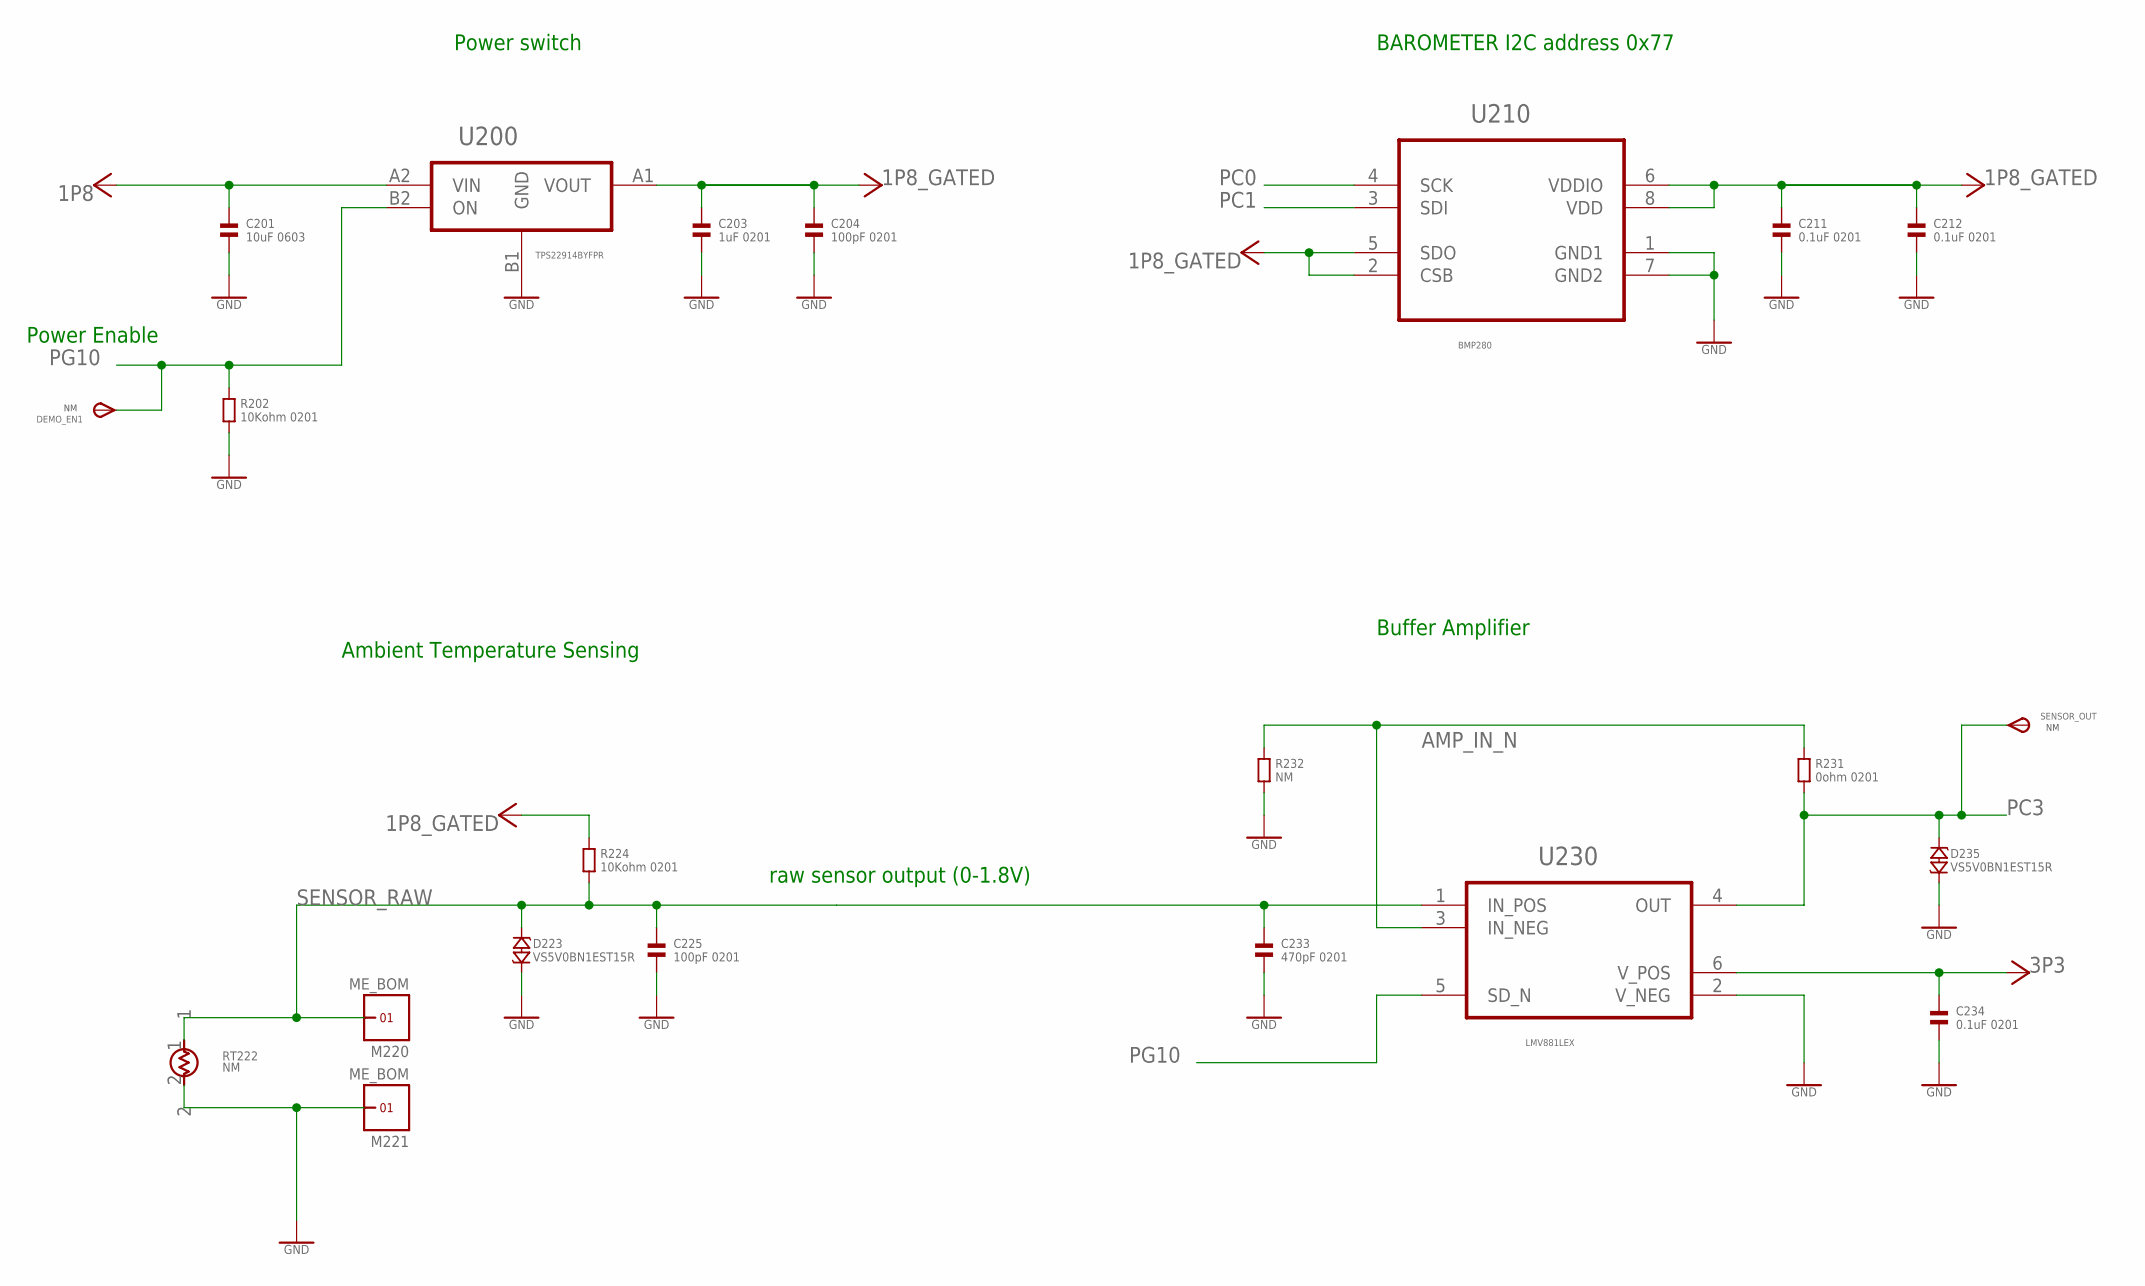
[picture p19: schematic DAUGHTER_SENSOR.sch, sheet 3, SENSOR]

Parts:
C201: 10uF 0603; 0603
C203: 1uF 0201; 0201
C204, C225: 100pF 0201; 0201
C211, C212, C234: 0.1uF 0201; 0201
C233: 470pF 0201; 0201
D223, D235: VS5V0BN1EST15R; CHIP_0201
DEMO_EN1: NM; TP11R
M220, M221: ME_BOM; UNIVERSAL_CONTACT
R202, R224: 10Kohm 0201; 0201
R231: 0ohm 0201; 0201
R232: NM; 0201
RT222: NM; 0201
SENSOR_OUT: NM; TP11R
U200: TPS22914BYFPR; BGA0_75SQ_PS0_4_P4
U210: BMP280; LGA2X2_5PS0_65_P8
U230: LMV881LEX; DFN1_5X1PS0_5P6

Connections:
1P8: C201.1, U200.A2 (VIN); also elsewhere on the board
1P8_GATED: C203.1, C204.1, C211.1, C212.1, R224.1, U200.A1 (VOUT), U210.2 (CSB), U210.5 (SDO), U210.6 (VDDIO), U210.8 (VDD)
3P3: C234.1, U230.6 (V_POS); also elsewhere on the board
AMP_IN_N: R231.1, R232.1, U230.3 (IN_NEG)
GND: C201.2, C203.2, C204.2, C211.2, C212.2, C225.2, C233.2, C234.2, D223.P$2 (2), D235.P$2 (2), M221.G1, R202.2, R232.2, RT222.2, U200.B1 (GND), U210.1 (GND1), U210.7 (GND2), U230.2 (V_NEG); also elsewhere on the board
PC0: U210.4 (SCK); also elsewhere on the board
PC1: U210.3 (SDI); also elsewhere on the board
PC3: D235.P$1 (1), R231.2, SENSOR_OUT.TP, U230.4 (OUT); also elsewhere on the board
PG10: DEMO_EN1.TP, R202.1, U200.B2 (ON), U230.5 (SD_N); also elsewhere on the board
SENSOR_RAW: C225.1, C233.1, D223.P$1 (1), M220.G1, R224.2, RT222.1, U230.1 (IN_POS)

Notes on the sheet:
Power Enable
BAROMETER I2C address 0x77
Power switch
Buffer Amplifier
Ambient Temperature Sensing
raw sensor output (0-1.8V)

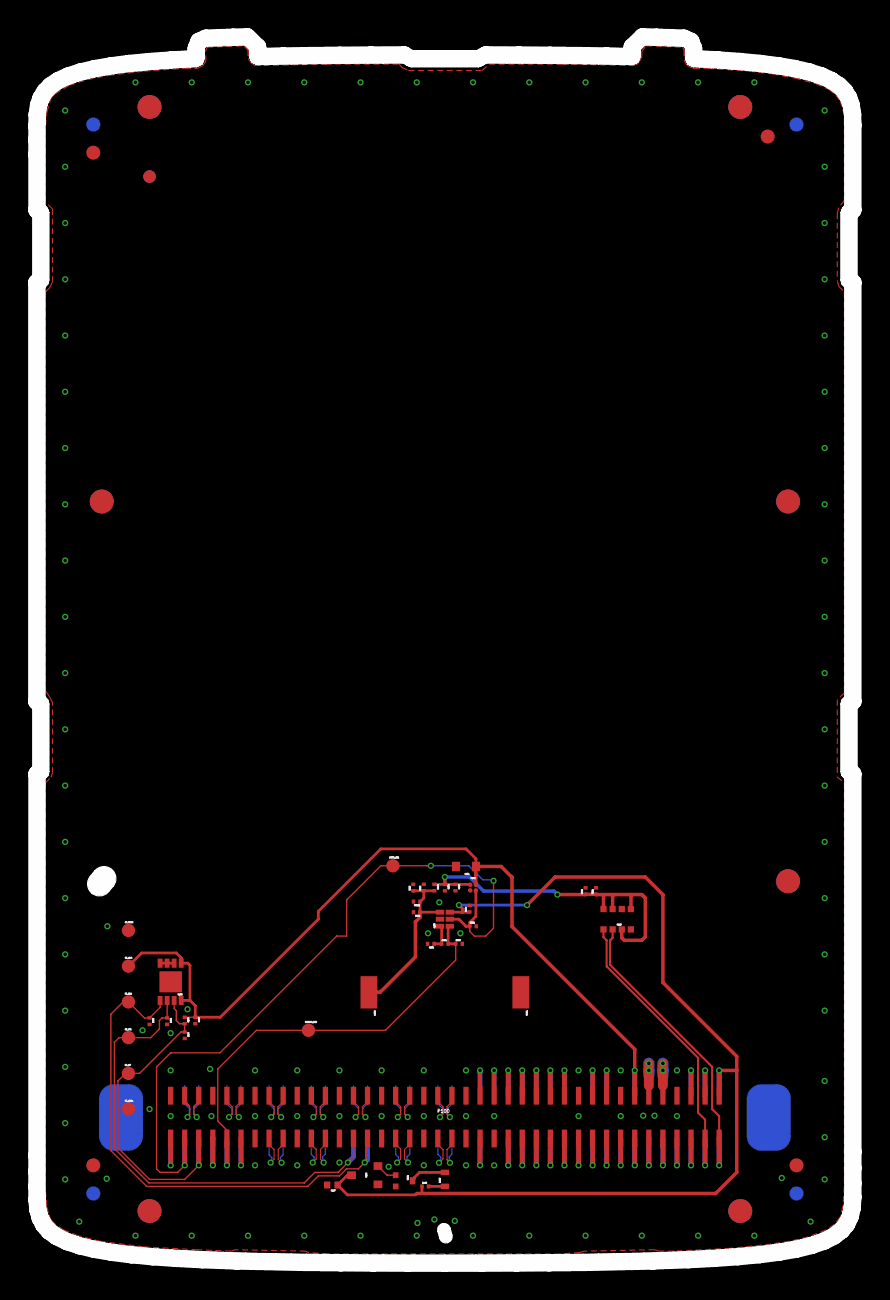
[picture p20: board DAUGHTER_SENSOR.brd from above]

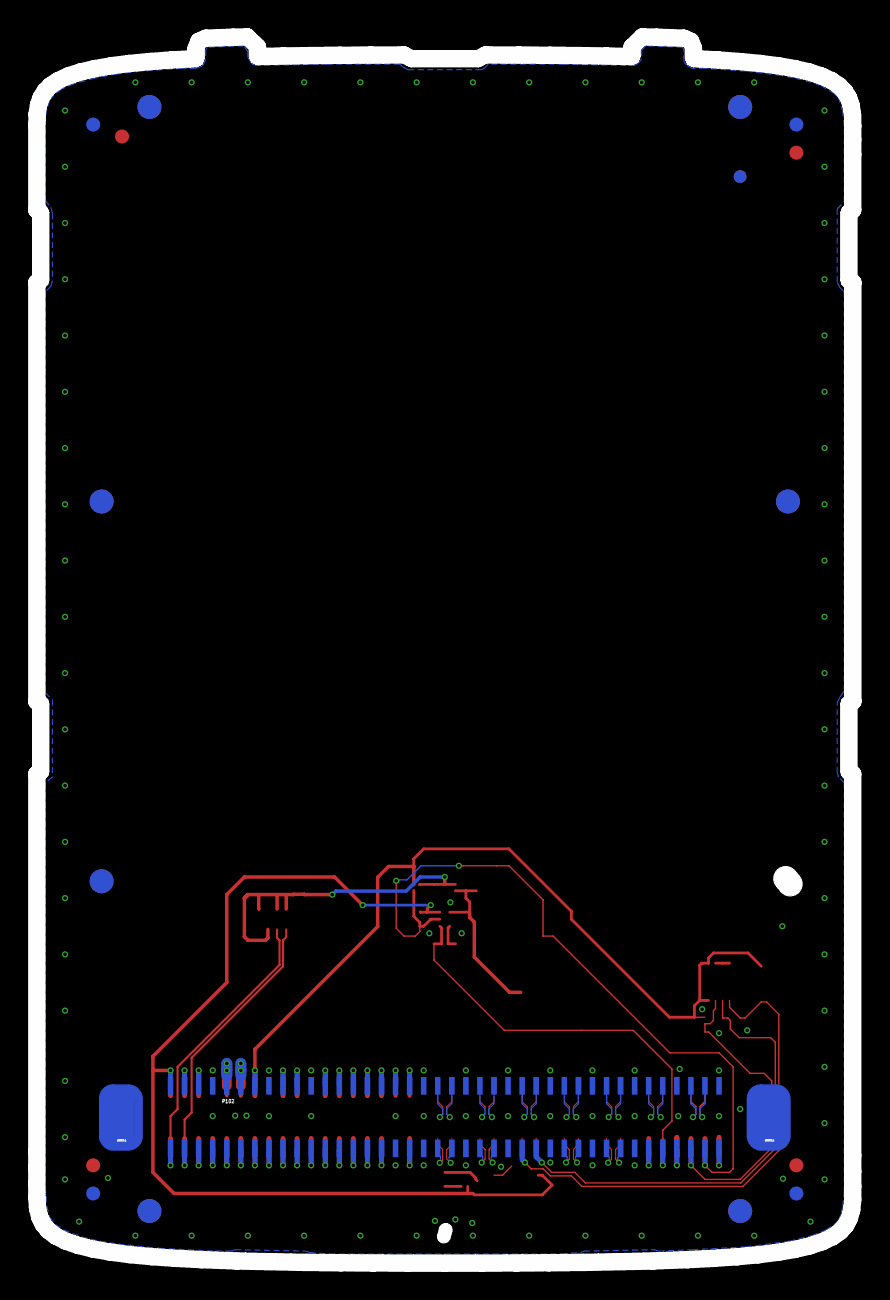
[picture p21: board DAUGHTER_SENSOR.brd from below]

Board: 4 copper layers, 58.1 x 87.2 mm, 43 parts (3 on the bottom side), 69 nets.
